LiyiqiInOsakaUniversity/control_board_set/firmware/README

The raspberry pi is the only supported platform yet.
The teensy code will be deleted in the future.
