LiyiqiInOsakaUniversity/control_board_set/electronics/dual/control_board.brd

## EAGLE design electronics/dual/control_board.brd (2020-11-19)

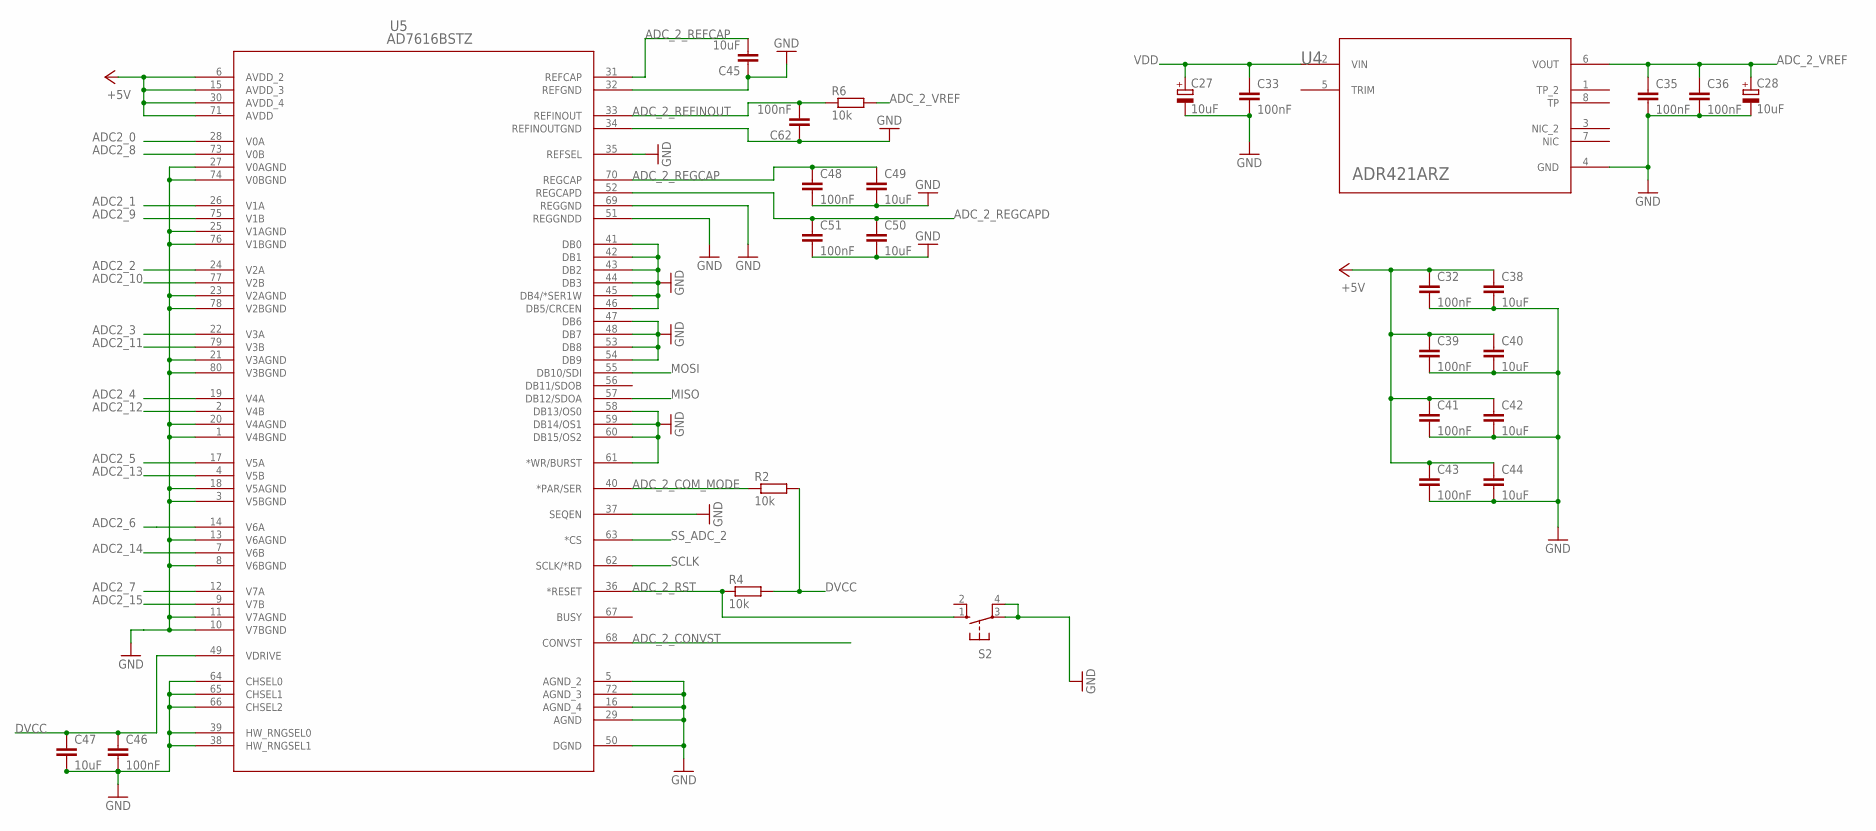
[picture p1: schematic control_board.sch, sheet 1, ADC]

Parts:
C27, C28: 10uF; SMC_A
C32, C33, C35, C36, C39, C41, C43, C46, C48, C51, C62: 100nF; C0603
C38, C40, C42, C44, C45, C47, C49, C50: 10uF; C0603
R2, R4, R6: 10k; R0603
S2: 10-XX; B3F-10XX
U4: ADR421ARZ; R_8
U5: AD7616BSTZ; ST_80_2

Connections:
+5V: C32.1, C38.1, C39.1, C40.1, C41.1, C42.1, C43.1, C44.1, U5.6 (AVDD_2), U5.15 (AVDD_3), U5.30 (AVDD_4), U5.71 (AVDD); also elsewhere on the board
ADC2_0: U5.28 (V0A); also elsewhere on the board
ADC2_1: U5.26 (V1A); also elsewhere on the board
ADC2_2: U5.24 (V2A); also elsewhere on the board
ADC2_3: U5.22 (V3A); also elsewhere on the board
ADC2_4: U5.19 (V4A); also elsewhere on the board
ADC2_5: U5.17 (V5A); also elsewhere on the board
ADC2_6: U5.14 (V6A); also elsewhere on the board
ADC2_7: U5.12 (V7A); also elsewhere on the board
ADC2_8: U5.73 (V0B); also elsewhere on the board
ADC2_9: U5.75 (V1B); also elsewhere on the board
ADC2_10: U5.77 (V2B); also elsewhere on the board
ADC2_11: U5.79 (V3B); also elsewhere on the board
ADC2_12: U5.2 (V4B); also elsewhere on the board
ADC2_13: U5.4 (V5B); also elsewhere on the board
ADC2_14: U5.7 (V6B); also elsewhere on the board
ADC2_15: U5.9 (V7B); also elsewhere on the board
ADC_2_COM_MODE: R2.1, U5.40 (*PAR/SER)
ADC_2_CONVST: U5.68 (CONVST); also elsewhere on the board
ADC_2_REFCAP: C45.2, U5.31 (REFCAP)
ADC_2_REFINOUT: C62.2, R6.1, U5.33 (REFINOUT)
ADC_2_REGCAP: C48.1, C49.1, U5.70 (REGCAP)
ADC_2_REGCAPD: C50.1, C51.1, U5.52 (REGCAPD)
ADC_2_RST: R4.1, S2.1 (S), U5.36 (*RESET)
ADC_2_VREF: C28.+, C35.1, C36.1, R6.2, U4.6 (VOUT)
DVCC: C46.1, C47.1, R2.2, R4.2, U5.49 (VDRIVE); also elsewhere on the board
GND: C27.-, C28.-, C32.2, C33.2, C35.2, C36.2, C38.2, C39.2, C40.2, C41.2, C42.2, C43.2, C44.2, C45.1, C46.2, C47.2, C48.2, C49.2, C50.2, C51.2, C62.1, S2.3, S2.4 (P1), U4.4 (GND), U5.1 (V4BGND), U5.3 (V5BGND), U5.5 (AGND_2), U5.8 (V6BGND), U5.10 (V7BGND), U5.11 (V7AGND), U5.13 (V6AGND), U5.16 (AGND_4), U5.18 (V5AGND), U5.20 (V4AGND), U5.21 (V3AGND), U5.23 (V2AGND), U5.25 (V1AGND), U5.27 (V0AGND), U5.29 (AGND), U5.32 (REFGND), U5.34 (REFINOUTGND), U5.35 (REFSEL), U5.37 (SEQEN), U5.38 (HW_RNGSEL1), U5.39 (HW_RNGSEL0), U5.41 (DB0), U5.42 (DB1), U5.43 (DB2), U5.44 (DB3), U5.45 (DB4/*SER1W), U5.46 (DB5/CRCEN), U5.47 (DB6), U5.48 (DB7), U5.50 (DGND), U5.51 (REGGNDD), U5.53 (DB8), U5.54 (DB9), U5.58 (DB13/OS0), U5.59 (DB14/OS1), U5.60 (DB15/OS2), U5.61 (*WR/BURST), U5.64 (CHSEL0), U5.65 (CHSEL1), U5.66 (CHSEL2), U5.69 (REGGND), U5.72 (AGND_3), U5.74 (V0BGND), U5.76 (V1BGND), U5.78 (V2BGND), U5.80 (V3BGND); also elsewhere on the board
MISO: U5.57 (DB12/SDOA); also elsewhere on the board
MOSI: U5.55 (DB10/SDI); also elsewhere on the board
SCLK: U5.62 (SCLK/*RD); also elsewhere on the board
SS_ADC_2: U5.63 (*CS); also elsewhere on the board
VDD: C27.+, C33.1, U4.2 (VIN); also elsewhere on the board

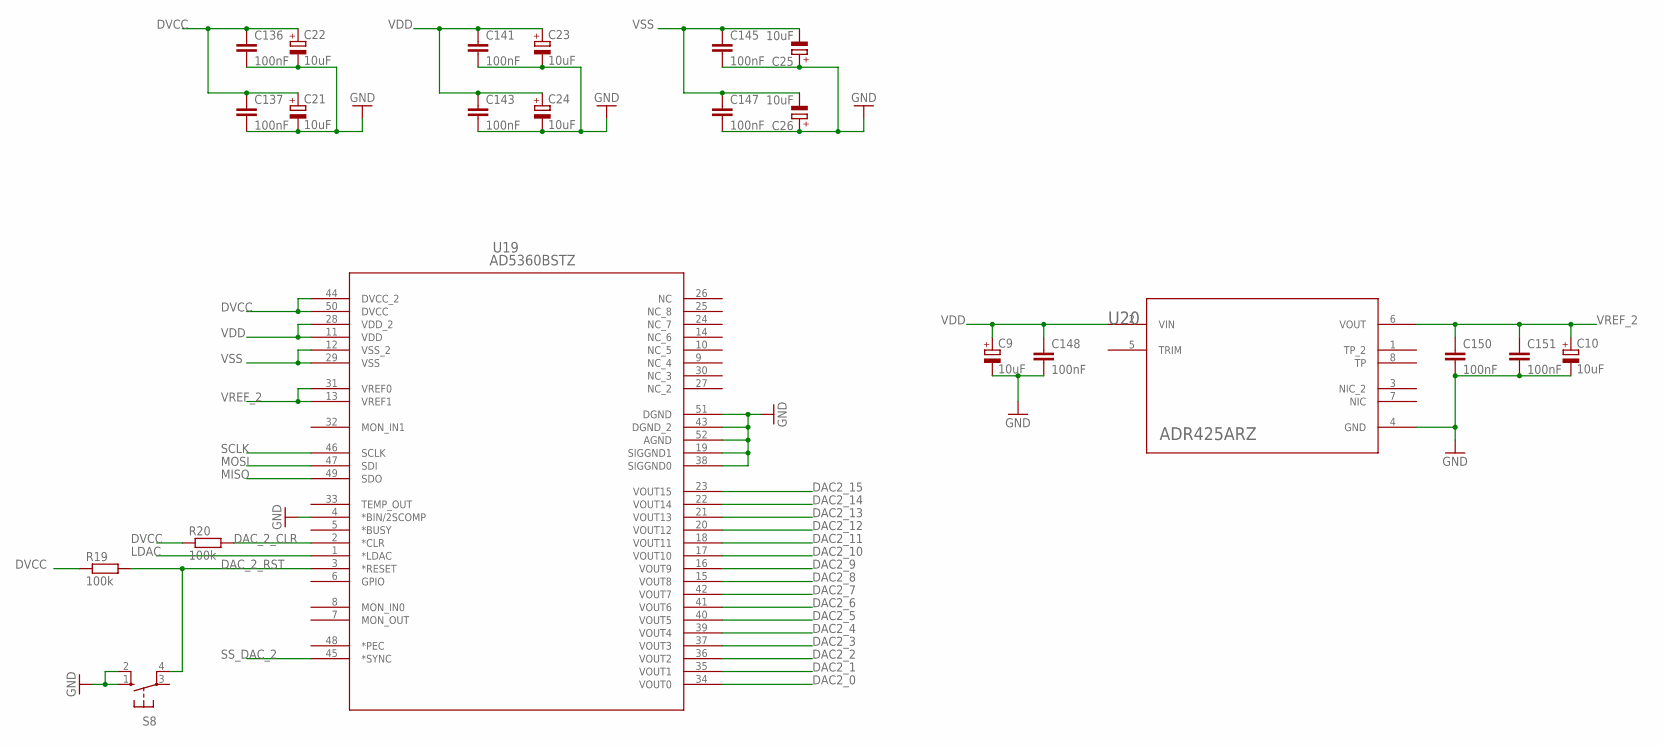
[picture p2: schematic control_board.sch, sheet 2, DAC]

Parts:
C9, C10, C21, C22, C23, C24, C25, C26: 10uF; SMC_A
C136, C137, C141, C143, C145, C147, C148, C150, C151: 100nF; C0603
R19, R20: 100k; R0603
S8: 10-XX; B3F-10XX
U19: AD5360BSTZ; ST_52
U20: ADR425ARZ; R_8

Connections:
DAC2_0: U19.34 (VOUT0); also elsewhere on the board
DAC2_1: U19.35 (VOUT1); also elsewhere on the board
DAC2_2: U19.36 (VOUT2); also elsewhere on the board
DAC2_3: U19.37 (VOUT3); also elsewhere on the board
DAC2_4: U19.39 (VOUT4); also elsewhere on the board
DAC2_5: U19.40 (VOUT5); also elsewhere on the board
DAC2_6: U19.41 (VOUT6); also elsewhere on the board
DAC2_7: U19.42 (VOUT7); also elsewhere on the board
DAC2_8: U19.15 (VOUT8); also elsewhere on the board
DAC2_9: U19.16 (VOUT9); also elsewhere on the board
DAC2_10: U19.17 (VOUT10); also elsewhere on the board
DAC2_11: U19.18 (VOUT11); also elsewhere on the board
DAC2_12: U19.20 (VOUT12); also elsewhere on the board
DAC2_13: U19.21 (VOUT13); also elsewhere on the board
DAC2_14: U19.22 (VOUT14); also elsewhere on the board
DAC2_15: U19.23 (VOUT15); also elsewhere on the board
DAC_2_CLR: R20.2, U19.2 (*CLR)
DAC_2_RST: R19.2, S8.4 (P1), U19.3 (*RESET)
DVCC: C21.+, C22.+, C136.1, C137.1, R19.1, R20.1, U19.44 (DVCC_2), U19.50 (DVCC); also elsewhere on the board
GND: C9.-, C10.-, C21.-, C22.-, C23.-, C24.-, C25.+, C26.+, C136.2, C137.2, C141.2, C143.2, C145.2, C147.2, C148.2, C150.2, C151.2, S8.1 (S), S8.2 (S1), U19.4 (*BIN/2SCOMP), U19.19 (SIGGND1), U19.38 (SIGGND0), U19.43 (DGND_2), U19.51 (DGND), U19.52 (AGND), U20.4 (GND); also elsewhere on the board
LDAC: U19.1 (*LDAC); also elsewhere on the board
MISO: U19.49 (SDO); also elsewhere on the board
MOSI: U19.47 (SDI); also elsewhere on the board
SCLK: U19.46 (SCLK); also elsewhere on the board
SS_DAC_2: U19.45 (*SYNC); also elsewhere on the board
VDD: C9.+, C23.+, C24.+, C141.1, C143.1, C148.1, U19.11 (VDD), U19.28 (VDD_2), U20.2 (VIN); also elsewhere on the board
VREF_2: C10.+, C150.1, C151.1, U19.13 (VREF1), U19.31 (VREF0), U20.6 (VOUT)
VSS: C25.-, C26.-, C145.1, C147.1, U19.12 (VSS_2), U19.29 (VSS); also elsewhere on the board

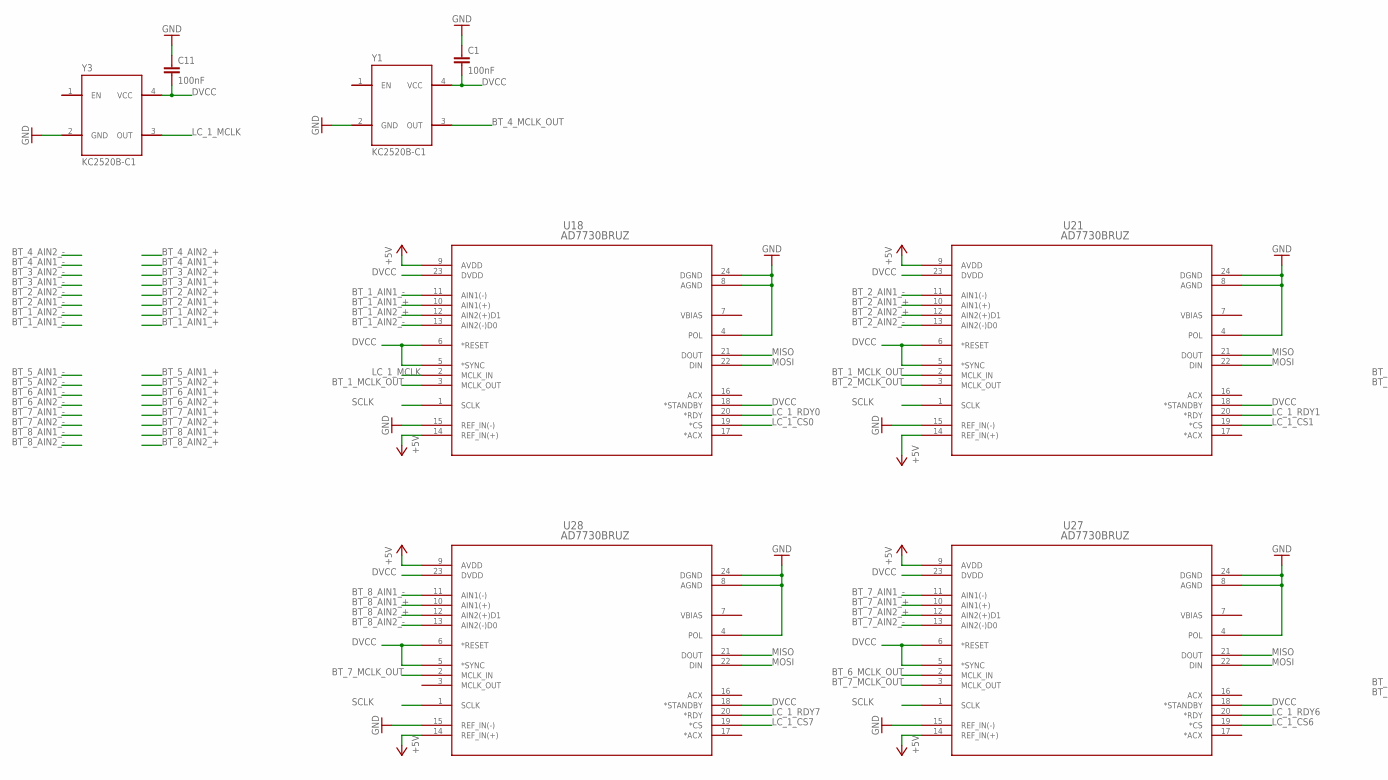
[picture p3: schematic control_board.sch, sheet 3, LoadCell, part in row 1, column 1]

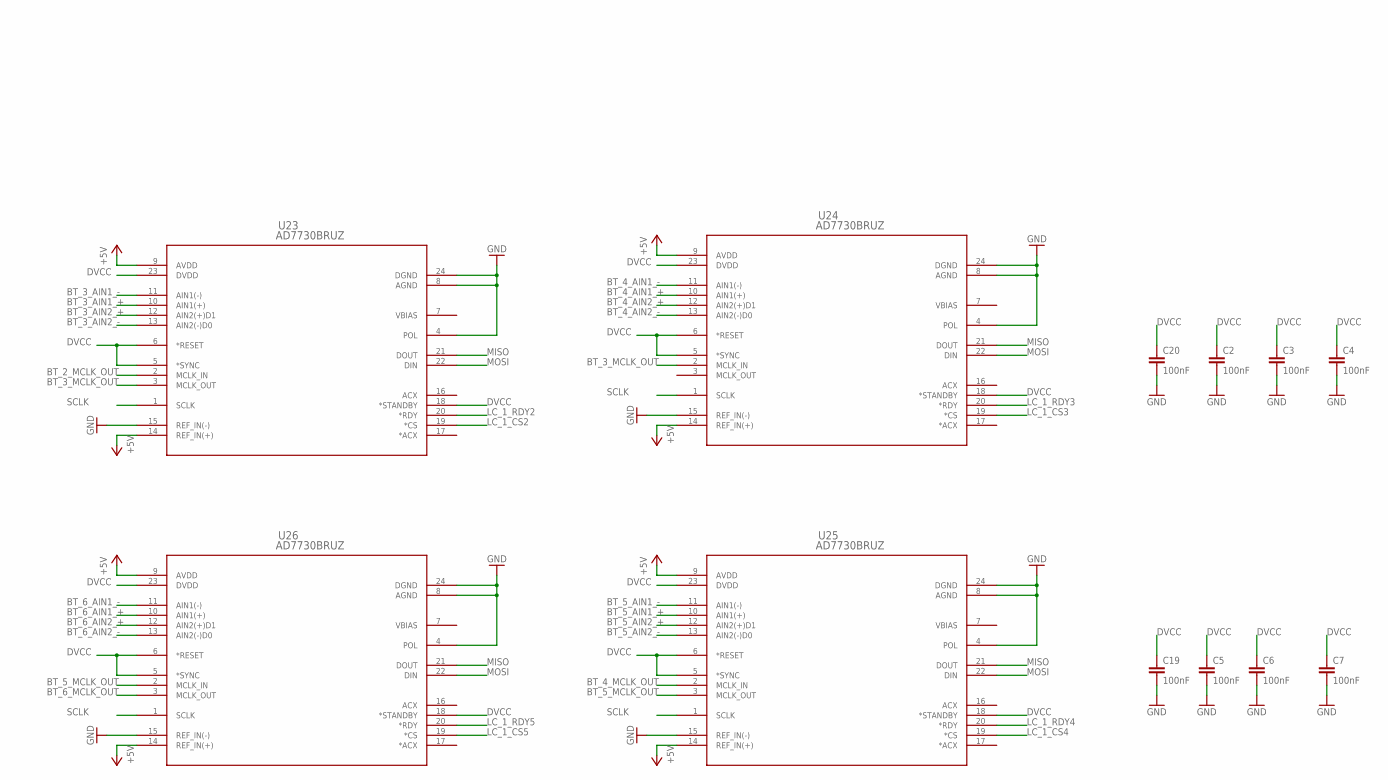
[picture p4: schematic control_board.sch, sheet 3, LoadCell, part in row 1, column 2]

Parts:
C1, C2, C3, C4, C5, C6, C7, C11, C19, C20: 100nF; C0603
U18, U21, U23, U24, U25, U26, U27, U28: AD7730BRUZ; RU_24
Y1, Y3: KC2520B-C1

Connections:
+5V: U18.9 (AVDD), U18.14 (REF_IN(+)), U21.9 (AVDD), U21.14 (REF_IN(+)), U23.9 (AVDD), U23.14 (REF_IN(+)), U24.9 (AVDD), U24.14 (REF_IN(+)), U25.9 (AVDD), U25.14 (REF_IN(+)), U26.9 (AVDD), U26.14 (REF_IN(+)), U27.9 (AVDD), U27.14 (REF_IN(+)), U28.9 (AVDD), U28.14 (REF_IN(+)); also elsewhere on the board
BT_1_AIN1_+: U18.10 (AIN1(+)); also elsewhere on the board
BT_1_AIN1_-: U18.11 (AIN1(-)); also elsewhere on the board
BT_1_AIN2_+: U18.12 (AIN2(+)D1); also elsewhere on the board
BT_1_AIN2_-: U18.13 (AIN2(-)D0); also elsewhere on the board
BT_1_MCLK_OUT: U18.3 (MCLK_OUT), U21.2 (MCLK_IN)
BT_2_AIN1_+: U21.10 (AIN1(+)); also elsewhere on the board
BT_2_AIN1_-: U21.11 (AIN1(-)); also elsewhere on the board
BT_2_AIN2_+: U21.12 (AIN2(+)D1); also elsewhere on the board
BT_2_AIN2_-: U21.13 (AIN2(-)D0); also elsewhere on the board
BT_2_MCLK_OUT: U21.3 (MCLK_OUT), U23.2 (MCLK_IN)
BT_3_AIN1_+: U23.10 (AIN1(+)); also elsewhere on the board
BT_3_AIN1_-: U23.11 (AIN1(-)); also elsewhere on the board
BT_3_AIN2_+: U23.12 (AIN2(+)D1); also elsewhere on the board
BT_3_AIN2_-: U23.13 (AIN2(-)D0); also elsewhere on the board
BT_3_MCLK_OUT: U23.3 (MCLK_OUT), U24.2 (MCLK_IN)
BT_4_AIN1_+: U24.10 (AIN1(+)); also elsewhere on the board
BT_4_AIN1_-: U24.11 (AIN1(-)); also elsewhere on the board
BT_4_AIN2_+: U24.12 (AIN2(+)D1); also elsewhere on the board
BT_4_AIN2_-: U24.13 (AIN2(-)D0); also elsewhere on the board
BT_4_MCLK_OUT: U25.2 (MCLK_IN), Y1.3 (OUT)
BT_5_AIN1_+: U25.10 (AIN1(+)); also elsewhere on the board
BT_5_AIN1_-: U25.11 (AIN1(-)); also elsewhere on the board
BT_5_AIN2_+: U25.12 (AIN2(+)D1); also elsewhere on the board
BT_5_AIN2_-: U25.13 (AIN2(-)D0); also elsewhere on the board
BT_5_MCLK_OUT: U25.3 (MCLK_OUT), U26.2 (MCLK_IN)
BT_6_AIN1_+: U26.10 (AIN1(+)); also elsewhere on the board
BT_6_AIN1_-: U26.11 (AIN1(-)); also elsewhere on the board
BT_6_AIN2_+: U26.12 (AIN2(+)D1); also elsewhere on the board
BT_6_AIN2_-: U26.13 (AIN2(-)D0); also elsewhere on the board
BT_6_MCLK_OUT: U26.3 (MCLK_OUT), U27.2 (MCLK_IN)
BT_7_AIN1_+: U27.10 (AIN1(+)); also elsewhere on the board
BT_7_AIN1_-: U27.11 (AIN1(-)); also elsewhere on the board
BT_7_AIN2_+: U27.12 (AIN2(+)D1); also elsewhere on the board
BT_7_AIN2_-: U27.13 (AIN2(-)D0); also elsewhere on the board
BT_7_MCLK_OUT: U27.3 (MCLK_OUT), U28.2 (MCLK_IN)
BT_8_AIN1_+: U28.10 (AIN1(+)); also elsewhere on the board
BT_8_AIN1_-: U28.11 (AIN1(-)); also elsewhere on the board
BT_8_AIN2_+: U28.12 (AIN2(+)D1); also elsewhere on the board
BT_8_AIN2_-: U28.13 (AIN2(-)D0); also elsewhere on the board
DVCC: C1.2, C2.1, C3.1, C4.1, C5.1, C6.1, C7.1, C11.2, C19.1, C20.1, U18.5 (*SYNC), U18.6 (*RESET), U18.18 (*STANDBY), U18.23 (DVDD), U21.5 (*SYNC), U21.6 (*RESET), U21.18 (*STANDBY), U21.23 (DVDD), U23.5 (*SYNC), U23.6 (*RESET), U23.18 (*STANDBY), U23.23 (DVDD), U24.5 (*SYNC), U24.6 (*RESET), U24.18 (*STANDBY), U24.23 (DVDD), U25.5 (*SYNC), U25.6 (*RESET), U25.18 (*STANDBY), U25.23 (DVDD), U26.5 (*SYNC), U26.6 (*RESET), U26.18 (*STANDBY), U26.23 (DVDD), U27.5 (*SYNC), U27.6 (*RESET), U27.18 (*STANDBY), U27.23 (DVDD), U28.5 (*SYNC), U28.6 (*RESET), U28.18 (*STANDBY), U28.23 (DVDD), Y1.4 (VCC), Y3.4 (VCC); also elsewhere on the board
GND: C1.1, C2.2, C3.2, C4.2, C5.2, C6.2, C7.2, C11.1, C19.2, C20.2, U18.4 (POL), U18.8 (AGND), U18.15 (REF_IN(-)), U18.24 (DGND), U21.4 (POL), U21.8 (AGND), U21.15 (REF_IN(-)), U21.24 (DGND), U23.4 (POL), U23.8 (AGND), U23.15 (REF_IN(-)), U23.24 (DGND), U24.4 (POL), U24.8 (AGND), U24.15 (REF_IN(-)), U24.24 (DGND), U25.4 (POL), U25.8 (AGND), U25.15 (REF_IN(-)), U25.24 (DGND), U26.4 (POL), U26.8 (AGND), U26.15 (REF_IN(-)), U26.24 (DGND), U27.4 (POL), U27.8 (AGND), U27.15 (REF_IN(-)), U27.24 (DGND), U28.4 (POL), U28.8 (AGND), U28.15 (REF_IN(-)), U28.24 (DGND), Y1.2 (GND), Y3.2 (GND); also elsewhere on the board
LC_1_CS0: U18.19 (*CS); also elsewhere on the board
LC_1_CS1: U21.19 (*CS); also elsewhere on the board
LC_1_CS2: U23.19 (*CS); also elsewhere on the board
LC_1_CS3: U24.19 (*CS); also elsewhere on the board
LC_1_CS4: U25.19 (*CS); also elsewhere on the board
LC_1_CS5: U26.19 (*CS); also elsewhere on the board
LC_1_CS6: U27.19 (*CS); also elsewhere on the board
LC_1_CS7: U28.19 (*CS); also elsewhere on the board
LC_1_MCLK: U18.2 (MCLK_IN), Y3.3 (OUT)
LC_1_RDY0: U18.20 (*RDY); also elsewhere on the board
LC_1_RDY1: U21.20 (*RDY); also elsewhere on the board
LC_1_RDY2: U23.20 (*RDY); also elsewhere on the board
LC_1_RDY3: U24.20 (*RDY); also elsewhere on the board
LC_1_RDY4: U25.20 (*RDY); also elsewhere on the board
LC_1_RDY5: U26.20 (*RDY); also elsewhere on the board
LC_1_RDY6: U27.20 (*RDY); also elsewhere on the board
LC_1_RDY7: U28.20 (*RDY); also elsewhere on the board
MISO: U18.21 (DOUT), U21.21 (DOUT), U23.21 (DOUT), U24.21 (DOUT), U25.21 (DOUT), U26.21 (DOUT), U27.21 (DOUT), U28.21 (DOUT); also elsewhere on the board
MOSI: U18.22 (DIN), U21.22 (DIN), U23.22 (DIN), U24.22 (DIN), U25.22 (DIN), U26.22 (DIN), U27.22 (DIN), U28.22 (DIN); also elsewhere on the board
SCLK: U18.1 (SCLK), U21.1 (SCLK), U23.1 (SCLK), U24.1 (SCLK), U25.1 (SCLK), U26.1 (SCLK), U27.1 (SCLK), U28.1 (SCLK); also elsewhere on the board

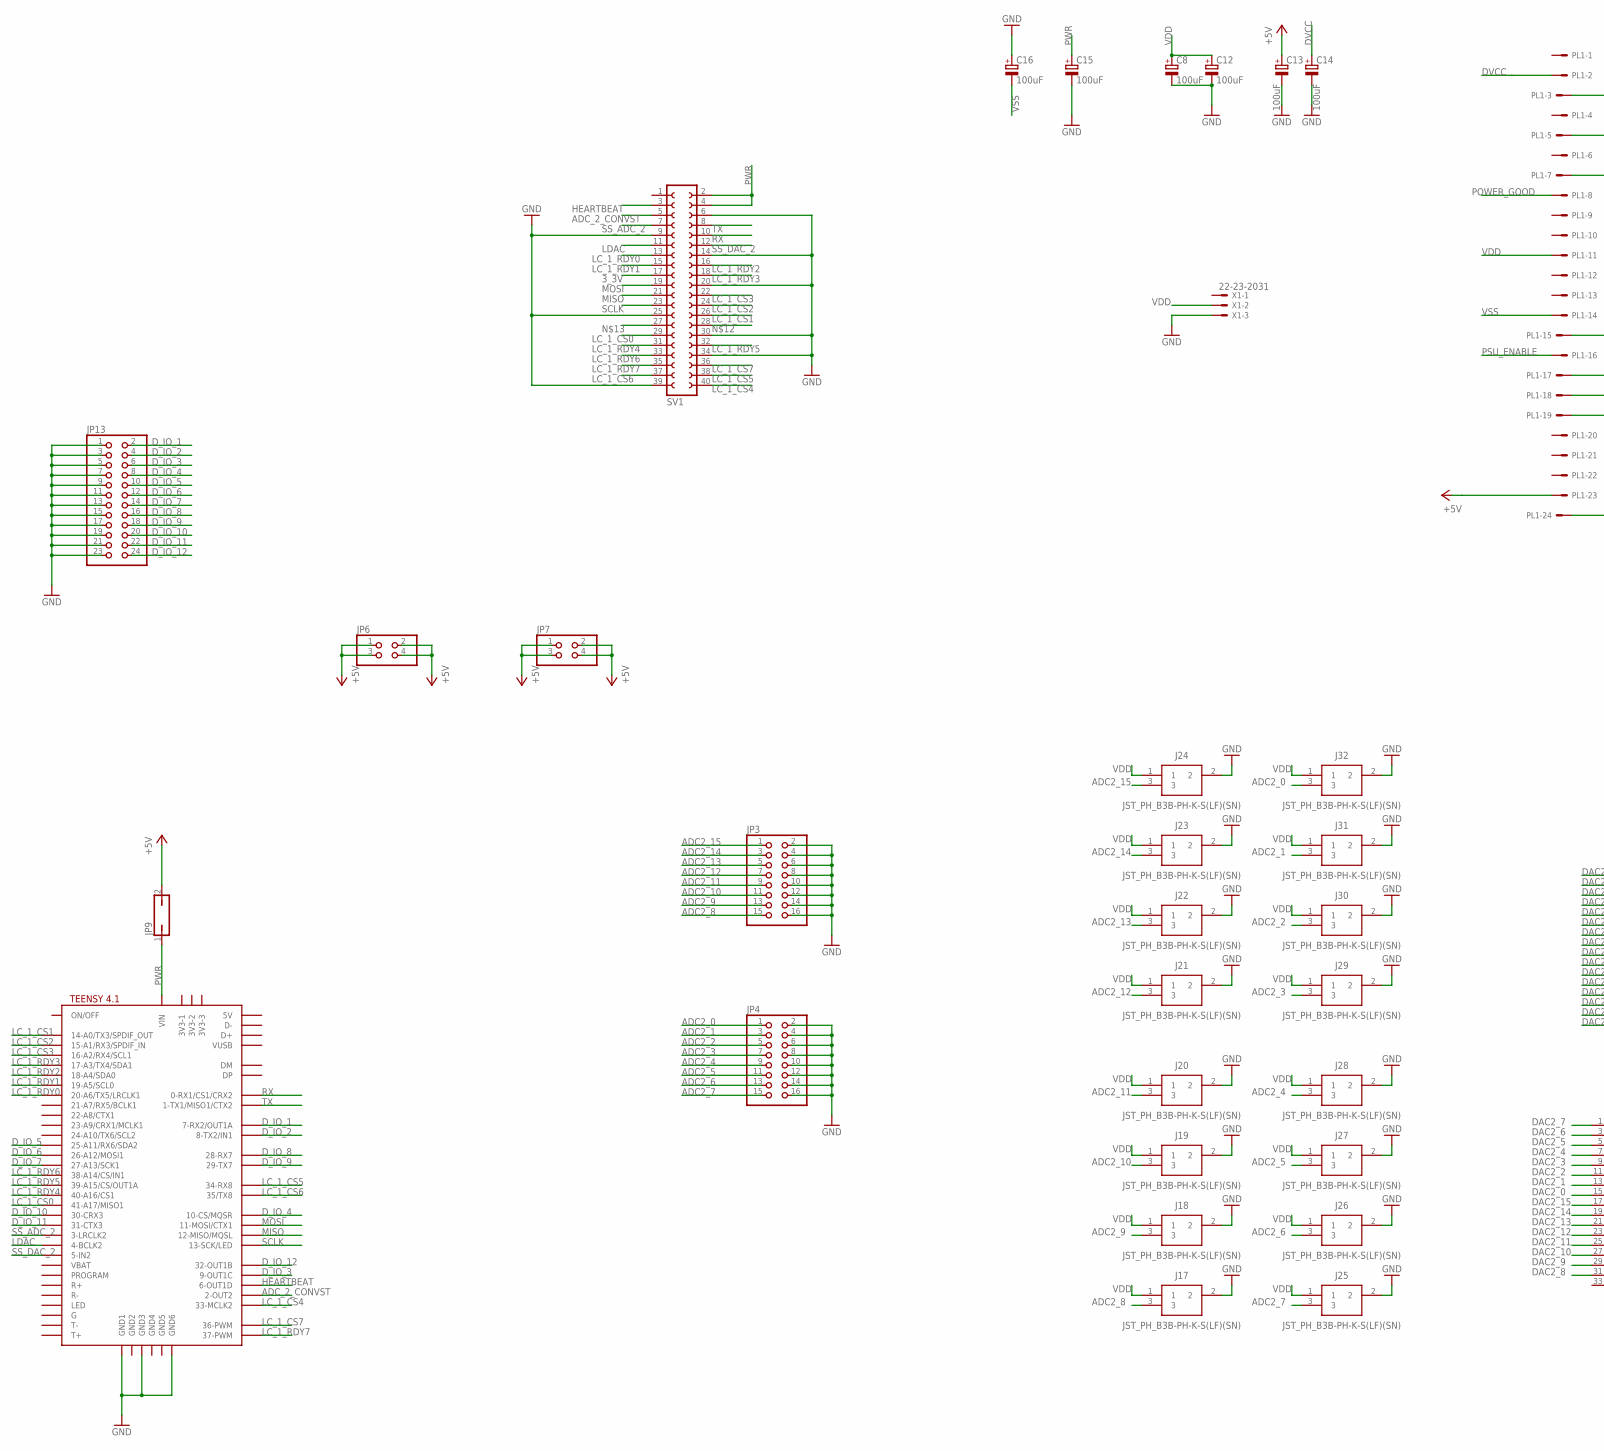
[picture p5: schematic control_board.sch, sheet 4, Connectors, part in row 1, column 1]

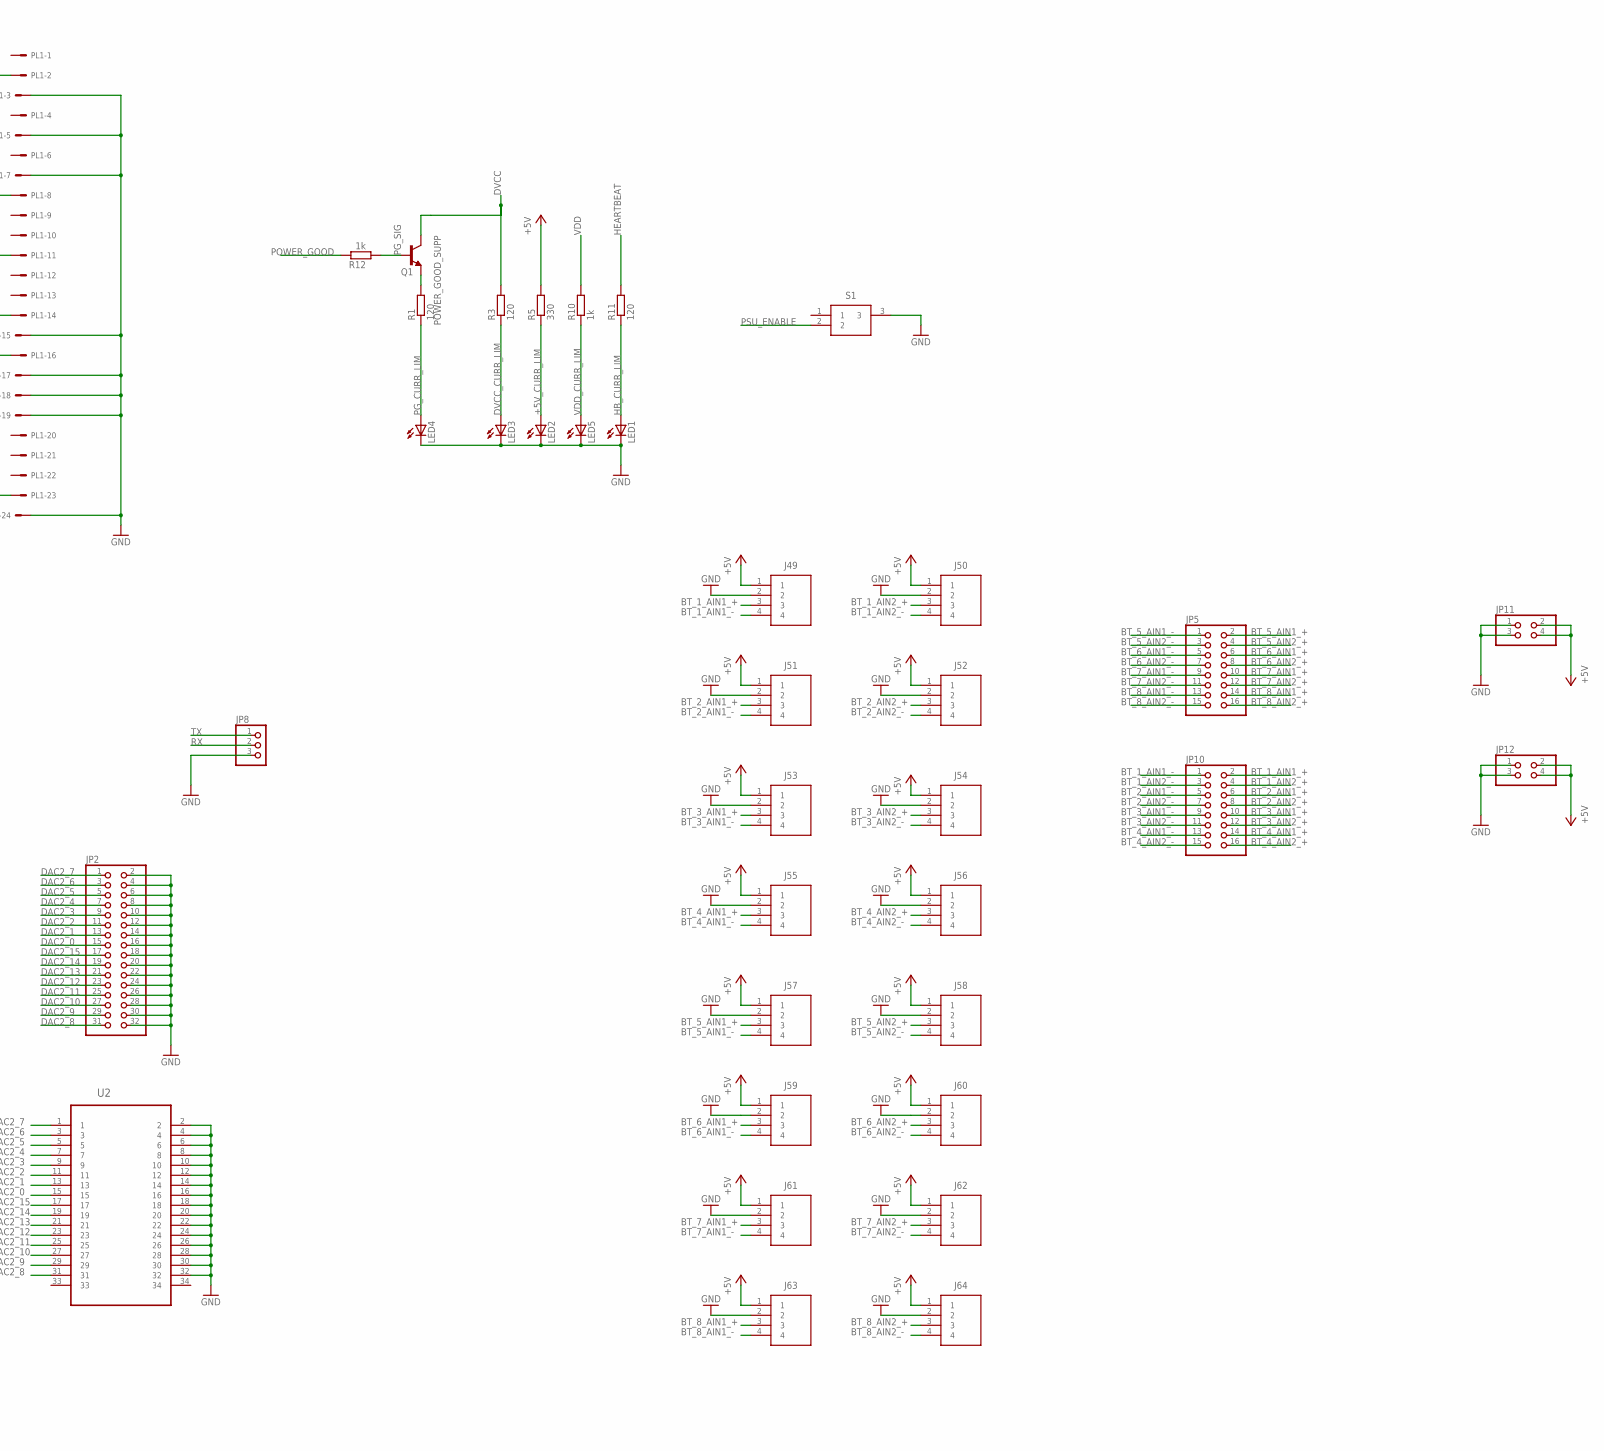
[picture p6: schematic control_board.sch, sheet 4, Connectors, part in row 1, column 2]

Parts:
C8, C12, C13, C14, C15, C16: 100uF; E3,5-8
J17, J18, J19, J20, J21, J22, J23, J24, J25, J26, J27, J28, J29, J30, J31, J32: JST_PH_B3B-PH-K-S(LF)(SN); JST_PH_SHDR3W50P0X200_1X3_790X450X600
J49, J50, J51, J52, J53, J54, J55, J56, J57, J58, J59, J60, J61, J62, J63, J64: B4B-PH-K-S(LF)(SN); SHDR4W50P0X200_1X4_990X450X600
JP2: PINHD-2X16/90; 2X16/90
JP3, JP4: PINHD-2X8/90; 2X08/90
JP5, JP10: PINHD-2X8; 2X08
JP6, JP7: PINHD-2X2/90; 2X02/90
JP8: PINHD-1X3; 1X03
JP9: JP1Q; JP1
JP11, JP12: PINHD-2X2; 2X02
JP13: PINHD-2X12_2.54-SMD; 2X12SMD
LED1, LED2, LED3, LED4, LED5: LEDCHIP-LED0603; CHIP-LED0603
PL1: 555X-24V; 5566-24
Q1: BCF29SMD; SOT23-BEC
R1, R3, R11: 120; R0805
R5: 330; R0805
R10, R12: 1k; R0805
S1: 1MS1T1B1M2QES-5
SV1: FE20-2
U2: AMP-5103309-7-34PIN_5103309-7; AMP-5103309-7-34PIN_TYCO_5103309-7
U$1: TEENSY41
X1: 22-23-2031

Connections:
3_3V: SV1.17
+5V: C13.+, J49.1, J50.1, J51.1, J52.1, J53.1, J54.1, J55.1, J56.1, J57.1, J58.1, J59.1, J60.1, J61.1, J62.1, J63.1, J64.1, JP6.1, JP6.2, JP6.3, JP6.4, JP7.1, JP7.2, JP7.3, JP7.4, JP9.2, JP11.2, JP11.4, JP12.2, JP12.4, PL1.23, R5.2; also elsewhere on the board
+5V_CURR_LIM: LED2.A, R5.1
ADC2_0: J32.3, JP4.1; also elsewhere on the board
ADC2_1: J31.3, JP4.3; also elsewhere on the board
ADC2_2: J30.3, JP4.5; also elsewhere on the board
ADC2_3: J29.3, JP4.7; also elsewhere on the board
ADC2_4: J28.3, JP4.9; also elsewhere on the board
ADC2_5: J27.3, JP4.11; also elsewhere on the board
ADC2_6: J26.3, JP4.13; also elsewhere on the board
ADC2_7: J25.3, JP4.15; also elsewhere on the board
ADC2_8: J17.3, JP3.15; also elsewhere on the board
ADC2_9: J18.3, JP3.13; also elsewhere on the board
ADC2_10: J19.3, JP3.11; also elsewhere on the board
ADC2_11: J20.3, JP3.9; also elsewhere on the board
ADC2_12: J21.3, JP3.7; also elsewhere on the board
ADC2_13: J22.3, JP3.5; also elsewhere on the board
ADC2_14: J23.3, JP3.3; also elsewhere on the board
ADC2_15: J24.3, JP3.1; also elsewhere on the board
ADC_2_CONVST: SV1.5, U$1.2-OUT2; also elsewhere on the board
BT_1_AIN1_+: J49.3, JP10.2; also elsewhere on the board
BT_1_AIN1_-: J49.4, JP10.1; also elsewhere on the board
BT_1_AIN2_+: J50.3, JP10.4; also elsewhere on the board
BT_1_AIN2_-: J50.4, JP10.3; also elsewhere on the board
BT_2_AIN1_+: J51.3, JP10.6; also elsewhere on the board
BT_2_AIN1_-: J51.4, JP10.5; also elsewhere on the board
BT_2_AIN2_+: J52.3, JP10.8; also elsewhere on the board
BT_2_AIN2_-: J52.4, JP10.7; also elsewhere on the board
BT_3_AIN1_+: J53.3, JP10.10; also elsewhere on the board
BT_3_AIN1_-: J53.4, JP10.9; also elsewhere on the board
BT_3_AIN2_+: J54.3, JP10.12; also elsewhere on the board
BT_3_AIN2_-: J54.4, JP10.11; also elsewhere on the board
BT_4_AIN1_+: J55.3, JP10.14; also elsewhere on the board
BT_4_AIN1_-: J55.4, JP10.13; also elsewhere on the board
BT_4_AIN2_+: J56.3, JP10.16; also elsewhere on the board
BT_4_AIN2_-: J56.4, JP10.15; also elsewhere on the board
BT_5_AIN1_+: J57.3, JP5.2; also elsewhere on the board
BT_5_AIN1_-: J57.4, JP5.1; also elsewhere on the board
BT_5_AIN2_+: J58.3, JP5.4; also elsewhere on the board
BT_5_AIN2_-: J58.4, JP5.3; also elsewhere on the board
BT_6_AIN1_+: J59.3, JP5.6; also elsewhere on the board
BT_6_AIN1_-: J59.4, JP5.5; also elsewhere on the board
BT_6_AIN2_+: J60.3, JP5.8; also elsewhere on the board
BT_6_AIN2_-: J60.4, JP5.7; also elsewhere on the board
BT_7_AIN1_+: J61.3, JP5.10; also elsewhere on the board
BT_7_AIN1_-: J61.4, JP5.9; also elsewhere on the board
BT_7_AIN2_+: J62.3, JP5.12; also elsewhere on the board
BT_7_AIN2_-: J62.4, JP5.11; also elsewhere on the board
BT_8_AIN1_+: J63.3, JP5.14; also elsewhere on the board
BT_8_AIN1_-: J63.4, JP5.13; also elsewhere on the board
BT_8_AIN2_+: J64.3, JP5.16; also elsewhere on the board
BT_8_AIN2_-: J64.4, JP5.15; also elsewhere on the board
DAC2_0: JP2.15, U2.15; also elsewhere on the board
DAC2_1: JP2.13, U2.13; also elsewhere on the board
DAC2_2: JP2.11, U2.11; also elsewhere on the board
DAC2_3: JP2.9, U2.9; also elsewhere on the board
DAC2_4: JP2.7, U2.7; also elsewhere on the board
DAC2_5: JP2.5, U2.5; also elsewhere on the board
DAC2_6: JP2.3, U2.3; also elsewhere on the board
DAC2_7: JP2.1, U2.1; also elsewhere on the board
DAC2_8: JP2.31, U2.31; also elsewhere on the board
DAC2_9: JP2.29, U2.29; also elsewhere on the board
DAC2_10: JP2.27, U2.27; also elsewhere on the board
DAC2_11: JP2.25, U2.25; also elsewhere on the board
DAC2_12: JP2.23, U2.23; also elsewhere on the board
DAC2_13: JP2.21, U2.21; also elsewhere on the board
DAC2_14: JP2.19, U2.19; also elsewhere on the board
DAC2_15: JP2.17, U2.17; also elsewhere on the board
DVCC: C14.+, PL1.2, Q1.C, R3.2; also elsewhere on the board
DVCC_CURR_LIM: LED3.A, R3.1
D_IO_1: JP13.2, U$1.7-RX2/OUT1A
D_IO_2: JP13.4, U$1.8-TX2/IN2 (8-TX2/IN1)
D_IO_3: JP13.6, U$1.9-OUT1C
D_IO_4: JP13.8, U$1.10-CS\MQSR (10-CS/MQSR)
D_IO_5: JP13.10, U$1.25-A11/RX6/SDA2
D_IO_6: JP13.12, U$1.26-A12/MOSI1
D_IO_7: JP13.14, U$1.27-A13/SCK1
D_IO_8: JP13.16, U$1.28-RX7
D_IO_9: JP13.18, U$1.29-TX7
D_IO_10: JP13.20, U$1.30-CRX3
D_IO_11: JP13.22, U$1.31-CTX3
D_IO_12: JP13.24, U$1.32-OUT1B
GND: C8.-, C12.-, C13.-, C14.-, C15.-, C16.+, J17.2, J18.2, J19.2, J20.2, J21.2, J22.2, J23.2, J24.2, J25.2, J26.2, J27.2, J28.2, J29.2, J30.2, J31.2, J32.2, J49.2, J50.2, J51.2, J52.2, J53.2, J54.2, J55.2, J56.2, J57.2, J58.2, J59.2, J60.2, J61.2, J62.2, J63.2, J64.2, JP2.2, JP2.4, JP2.6, JP2.8, JP2.10, JP2.12, JP2.14, JP2.16, JP2.18, JP2.20, JP2.22, JP2.24, JP2.26, JP2.28, JP2.30, JP2.32, JP3.2, JP3.4, JP3.6, JP3.8, JP3.10, JP3.12, JP3.14, JP3.16, JP4.2, JP4.4, JP4.6, JP4.8, JP4.10, JP4.12, JP4.14, JP4.16, JP8.3, JP11.1, JP11.3, JP12.1, JP12.3, JP13.1, JP13.3, JP13.5, JP13.7, JP13.9, JP13.11, JP13.13, JP13.15, JP13.17, JP13.19, JP13.21, JP13.23, LED1.C, LED2.C, LED3.C, LED4.C, LED5.C, PL1.3, PL1.5, PL1.7, PL1.15, PL1.17, PL1.18, PL1.19, PL1.24, S1.3, SV1.6, SV1.9, SV1.14, SV1.20, SV1.25, SV1.30, SV1.34, SV1.39, U2.2, U2.4, U2.6, U2.8, U2.10, U2.12, U2.14, U2.16, U2.18, U2.20, U2.22, U2.24, U2.26, U2.28, U2.30, U2.32, U$1.GND1, U$1.GND3, U$1.GND6, X1.3; also elsewhere on the board
HB_CURR_LIM: LED1.A, R11.1
HEARTBEAT: R11.2, SV1.3, U$1.6-OUT1D
LC_1_CS0: SV1.29, U$1.41-A17/MISO1; also elsewhere on the board
LC_1_CS1: SV1.26, U$1.14-A0/TX3/SPDIF_OUT; also elsewhere on the board
LC_1_CS2: SV1.24, U$1.15-A1/RX3/SPDIF_IN; also elsewhere on the board
LC_1_CS3: SV1.22, U$1.16-A2/RX4/SCL1; also elsewhere on the board
LC_1_CS4: SV1.40, U$1.33-MCLK2; also elsewhere on the board
LC_1_CS5: SV1.38, U$1.34-RX8; also elsewhere on the board
LC_1_CS6: SV1.37, U$1.35-TX8 (35/TX8); also elsewhere on the board
LC_1_CS7: SV1.36, U$1.36-PWM; also elsewhere on the board
LC_1_RDY0: SV1.13, U$1.20-A6/TX5/LRCLK1; also elsewhere on the board
LC_1_RDY1: SV1.15, U$1.19-A5/SCL0; also elsewhere on the board
LC_1_RDY2: SV1.16, U$1.18-A4/SDA0; also elsewhere on the board
LC_1_RDY3: SV1.18, U$1.17-A3/TX4/SDA1; also elsewhere on the board
LC_1_RDY4: SV1.31, U$1.40-A16/CS1; also elsewhere on the board
LC_1_RDY5: SV1.32, U$1.39-A15/CS/OUT1A; also elsewhere on the board
LC_1_RDY6: SV1.33, U$1.38-A14/CS/IN1; also elsewhere on the board
LC_1_RDY7: SV1.35, U$1.37-PWM; also elsewhere on the board
LDAC: SV1.11, U$1.4-BCLK2; also elsewhere on the board
MISO: SV1.21, U$1.12-MISO/MQSL; also elsewhere on the board
MOSI: SV1.19, U$1.11-MOSI/CTX1; also elsewhere on the board
PG_CURR_LIM: LED4.A, R1.1
PG_SIG: Q1.B, R12.1
POWER_GOOD: PL1.8, R12.2
POWER_GOOD_SUPP: Q1.E, R1.2
PSU_ENABLE: PL1.16, S1.2
PWR: C15.+, JP9.1, SV1.2, SV1.4, U$1.VIN
RX: JP8.2, SV1.10, U$1.0-RX1/CS1/CRX2
SCLK: SV1.23, U$1.13-SCK/LED; also elsewhere on the board
SS_ADC_2: SV1.7, U$1.3-LRCLK2; also elsewhere on the board
SS_DAC_2: SV1.12, U$1.5-IN2; also elsewhere on the board
TX: JP8.1, SV1.8, U$1.1-TX1/MISO1/CTX2
VDD: C8.+, C12.+, J17.1, J18.1, J19.1, J20.1, J21.1, J22.1, J23.1, J24.1, J25.1, J26.1, J27.1, J28.1, J29.1, J30.1, J31.1, J32.1, PL1.11, R10.2, X1.2; also elsewhere on the board
VDD_CURR_LIM: LED5.A, R10.1
VSS: C16.-, PL1.14; also elsewhere on the board
