LiyiqiInOsakaUniversity/control_board_set/electronics/dual/control_board.brd

## EAGLE design electronics/dual/control_board.brd (continued)

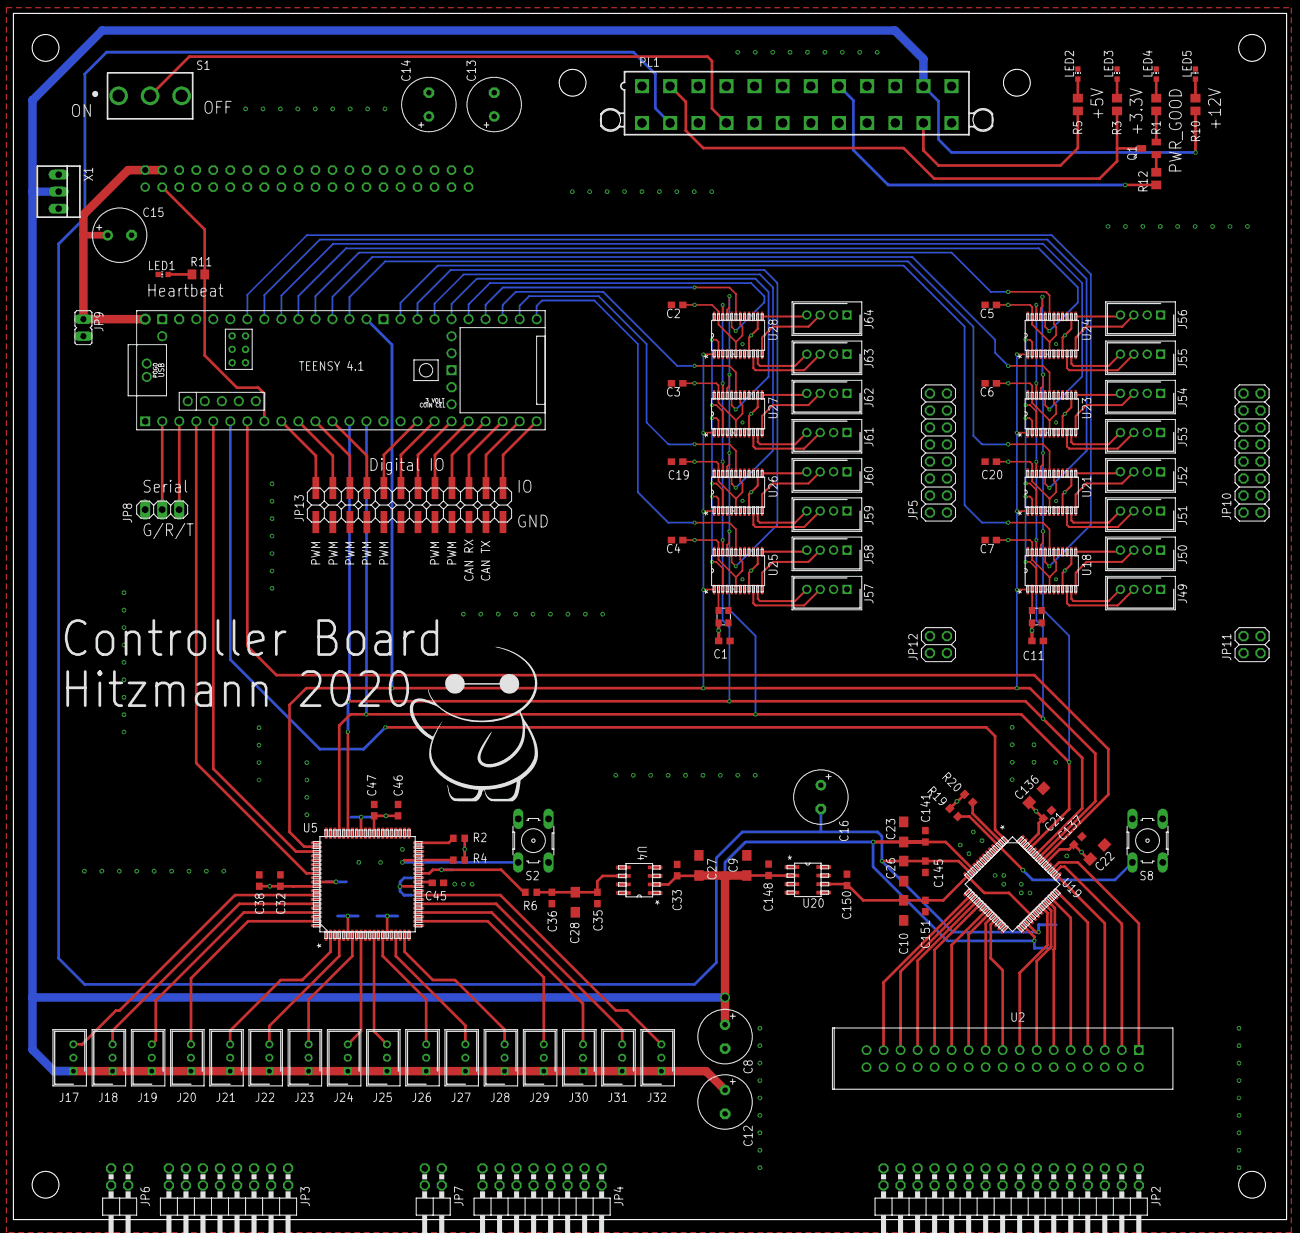
[picture p7: board control_board.brd from above]

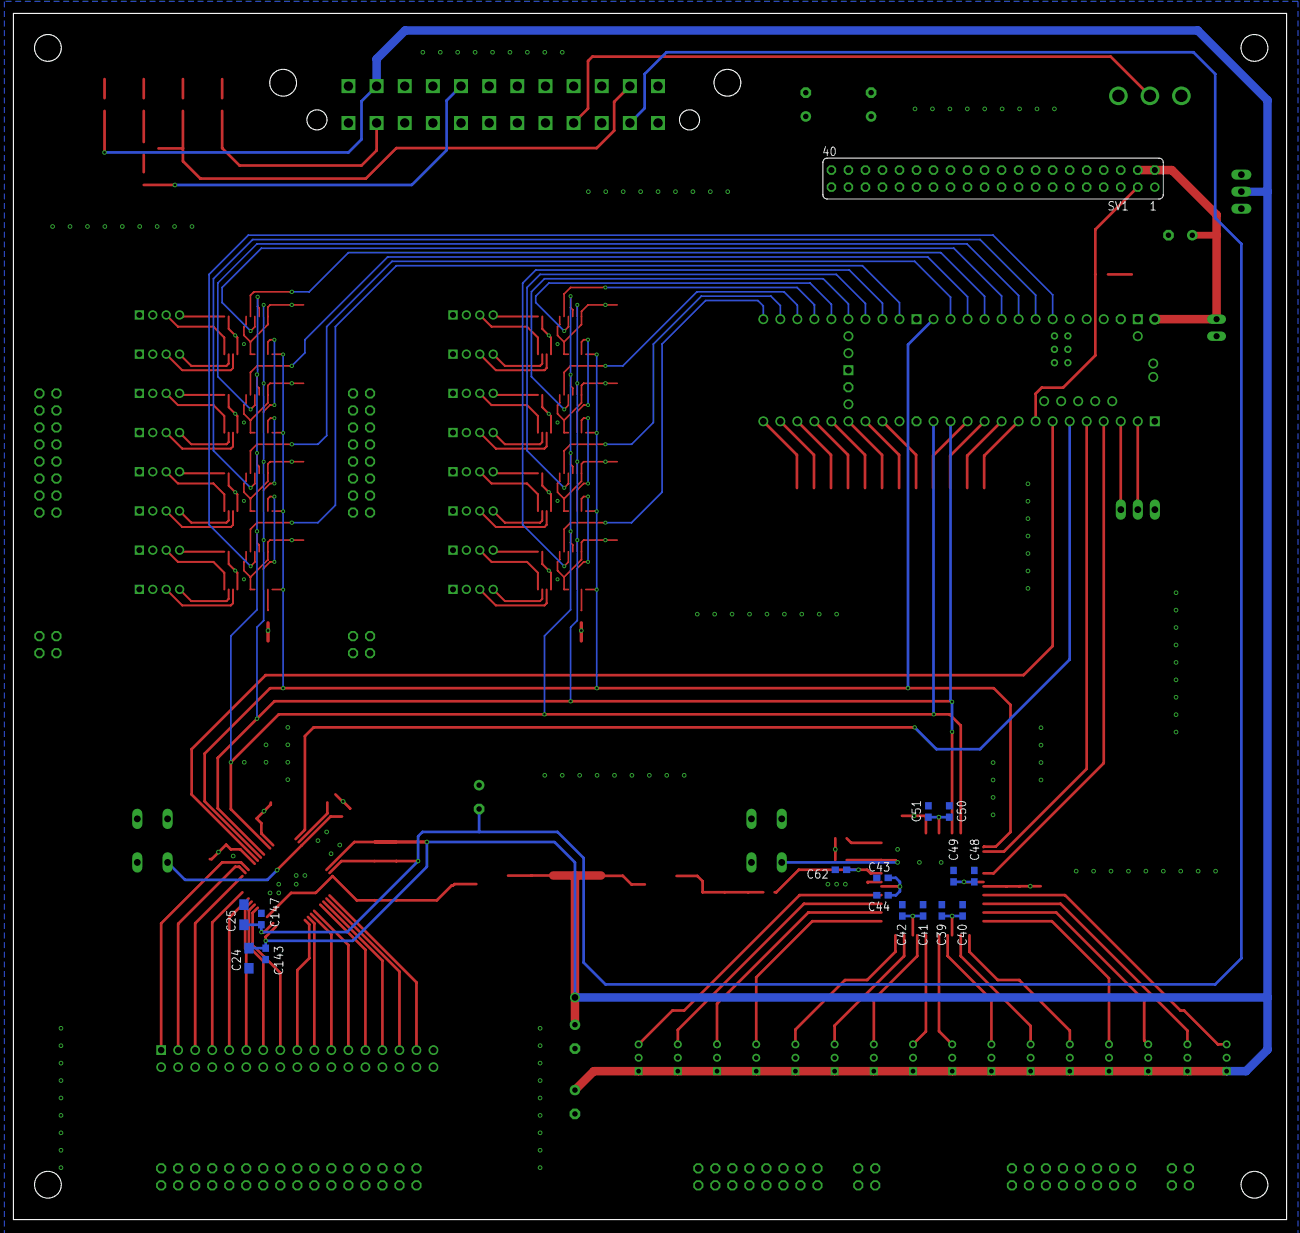
[picture p8: board control_board.brd from below]

Board: 4 copper layers, 190.0 x 180.0 mm, 137 parts (16 on the bottom side), 135 nets.
