LiyiqiInOsakaUniversity/control_board_set/electronics/tester_adapter_board.brd

## EAGLE design electronics/tester_adapter_board.brd (2020-11-19)

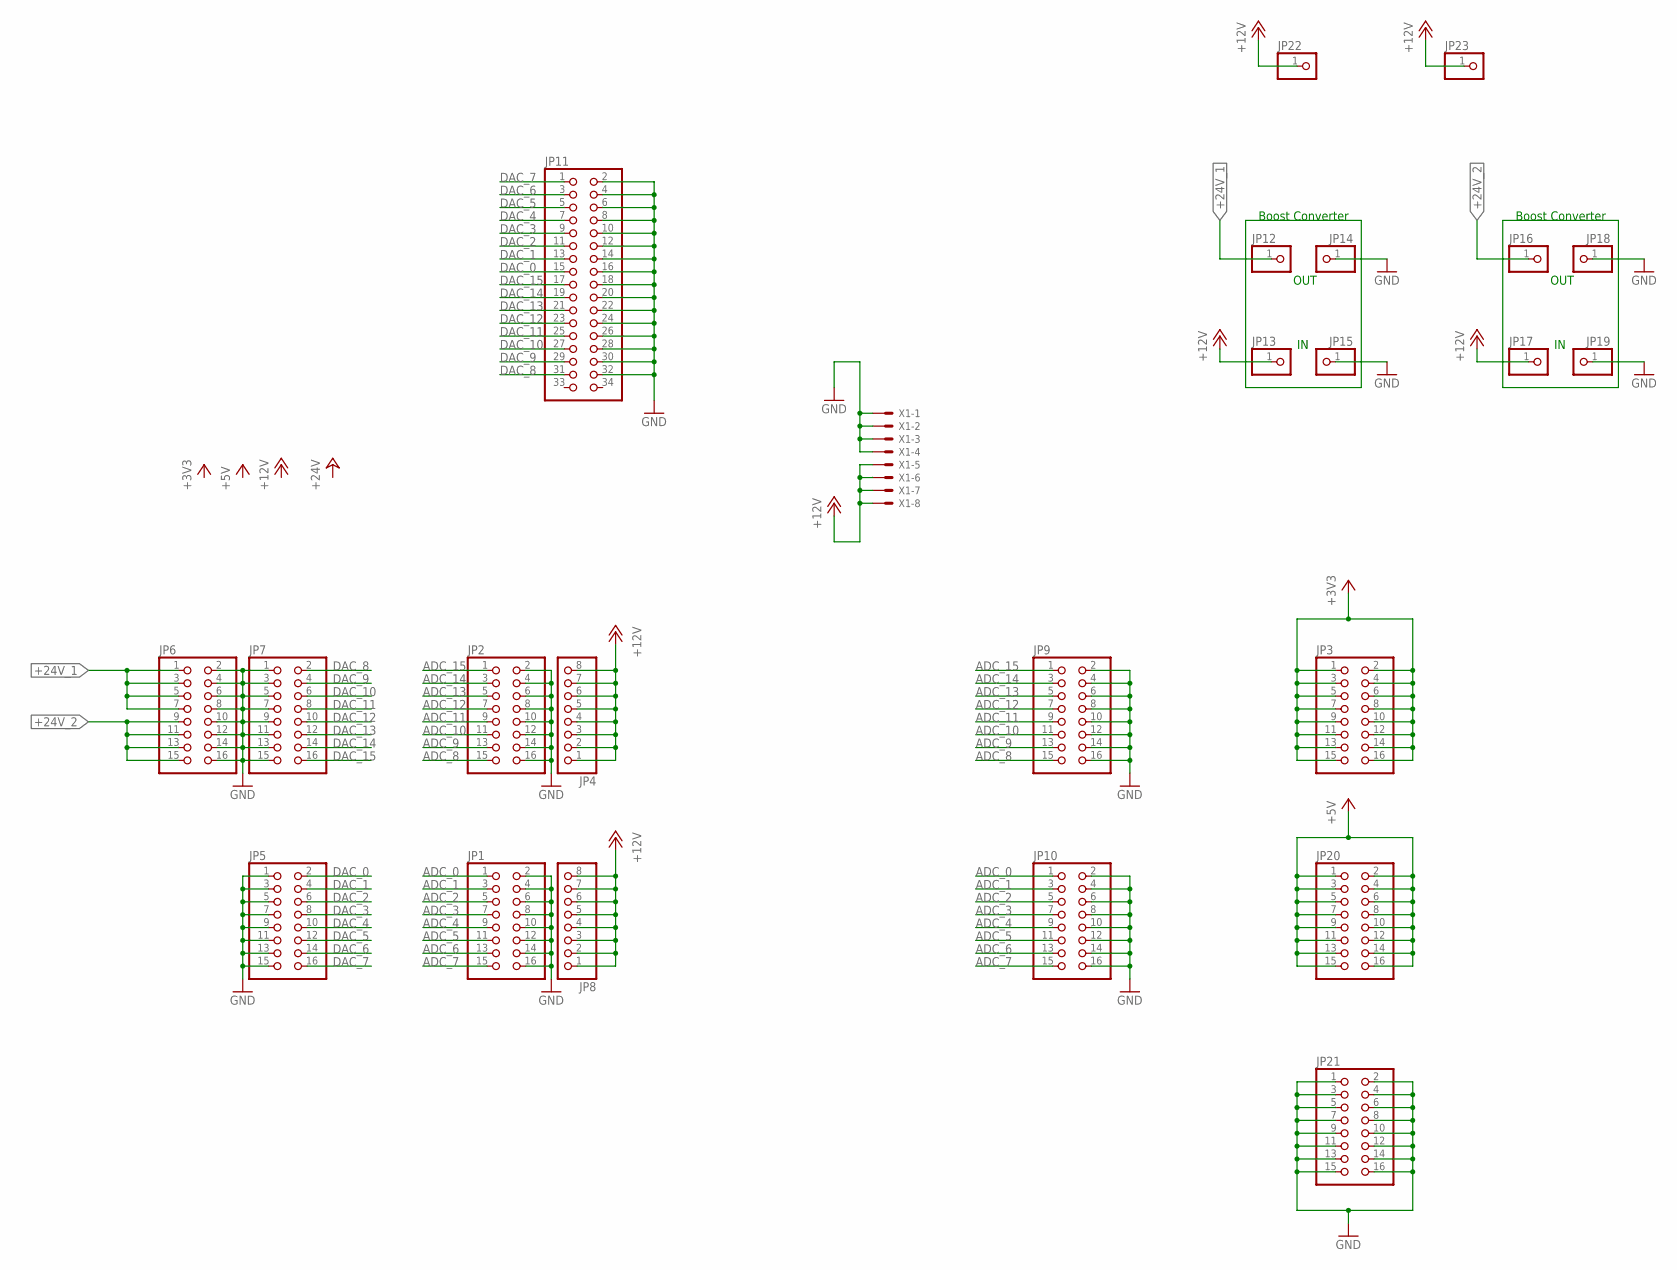
[picture p9: schematic tester_adapter_board.sch]

Parts:
JP1, JP2, JP3, JP5, JP6, JP7, JP9, JP10, JP20, JP21: PINHD-2X8; 2X08
JP4, JP8: PINHD-1X08_2.54-S; 1X08-S
JP11: PINHD-2X17; 2X17
JP12, JP13, JP16, JP17: PINHD-1X01_2.54; 1X01
JP14, JP15, JP18, JP19: PINHD-1X01_2.54-S; 1X01-S
JP22, JP23: PINHD-1X01_2.54-SMD; 1X01SMD
X1: 5566-8

Connections:
+3V3: JP3.1, JP3.2, JP3.3, JP3.4, JP3.5, JP3.6, JP3.7, JP3.8, JP3.9, JP3.10, JP3.11, JP3.12, JP3.13, JP3.14, JP3.15, JP3.16
+5V: JP20.1, JP20.2, JP20.3, JP20.4, JP20.5, JP20.6, JP20.7, JP20.8, JP20.9, JP20.10, JP20.11, JP20.12, JP20.13, JP20.14, JP20.15, JP20.16
+12V: JP4.1, JP4.2, JP4.3, JP4.4, JP4.5, JP4.6, JP4.7, JP4.8, JP8.1, JP8.2, JP8.3, JP8.4, JP8.5, JP8.6, JP8.7, JP8.8, JP13.1, JP17.1, JP22.1, JP23.1, X1.5, X1.6, X1.7, X1.8
+24V_1: JP6.1, JP6.3, JP6.5, JP6.7, JP12.1
+24V_2: JP6.9, JP6.11, JP6.13, JP6.15, JP16.1
ADC_0: JP1.1, JP10.1
ADC_1: JP1.3, JP10.3
ADC_2: JP1.5, JP10.5
ADC_3: JP1.7, JP10.7
ADC_4: JP1.9, JP10.9
ADC_5: JP1.11, JP10.11
ADC_6: JP1.13, JP10.13
ADC_7: JP1.15, JP10.15
ADC_8: JP2.15, JP9.15
ADC_9: JP2.13, JP9.13
ADC_10: JP2.11, JP9.11
ADC_11: JP2.9, JP9.9
ADC_12: JP2.7, JP9.7
ADC_13: JP2.5, JP9.5
ADC_14: JP2.3, JP9.3
ADC_15: JP2.1, JP9.1
DAC_0: JP5.2, JP11.15
DAC_1: JP5.4, JP11.13
DAC_2: JP5.6, JP11.11
DAC_3: JP5.8, JP11.9
DAC_4: JP5.10, JP11.7
DAC_5: JP5.12, JP11.5
DAC_6: JP5.14, JP11.3
DAC_7: JP5.16, JP11.1
DAC_8: JP7.2, JP11.31
DAC_9: JP7.4, JP11.29
DAC_10: JP7.6, JP11.27
DAC_11: JP7.8, JP11.25
DAC_12: JP7.10, JP11.23
DAC_13: JP7.12, JP11.21
DAC_14: JP7.14, JP11.19
DAC_15: JP7.16, JP11.17
GND: JP1.2, JP1.4, JP1.6, JP1.8, JP1.10, JP1.12, JP1.14, JP1.16, JP2.2, JP2.4, JP2.6, JP2.8, JP2.10, JP2.12, JP2.14, JP2.16, JP5.1, JP5.3, JP5.5, JP5.7, JP5.9, JP5.11, JP5.13, JP5.15, JP6.2, JP6.4, JP6.6, JP6.8, JP6.10, JP6.12, JP6.14, JP6.16, JP7.1, JP7.3, JP7.5, JP7.7, JP7.9, JP7.11, JP7.13, JP7.15, JP9.2, JP9.4, JP9.6, JP9.8, JP9.10, JP9.12, JP9.14, JP9.16, JP10.2, JP10.4, JP10.6, JP10.8, JP10.10, JP10.12, JP10.14, JP10.16, JP11.2, JP11.4, JP11.6, JP11.8, JP11.10, JP11.12, JP11.14, JP11.16, JP11.18, JP11.20, JP11.22, JP11.24, JP11.26, JP11.28, JP11.30, JP11.32, JP14.1, JP15.1, JP18.1, JP19.1, JP21.1, JP21.2, JP21.3, JP21.4, JP21.5, JP21.6, JP21.7, JP21.8, JP21.9, JP21.10, JP21.11, JP21.12, JP21.13, JP21.14, JP21.15, JP21.16, X1.1, X1.2, X1.3, X1.4

Notes on the sheet:
Boost Converter
OUT

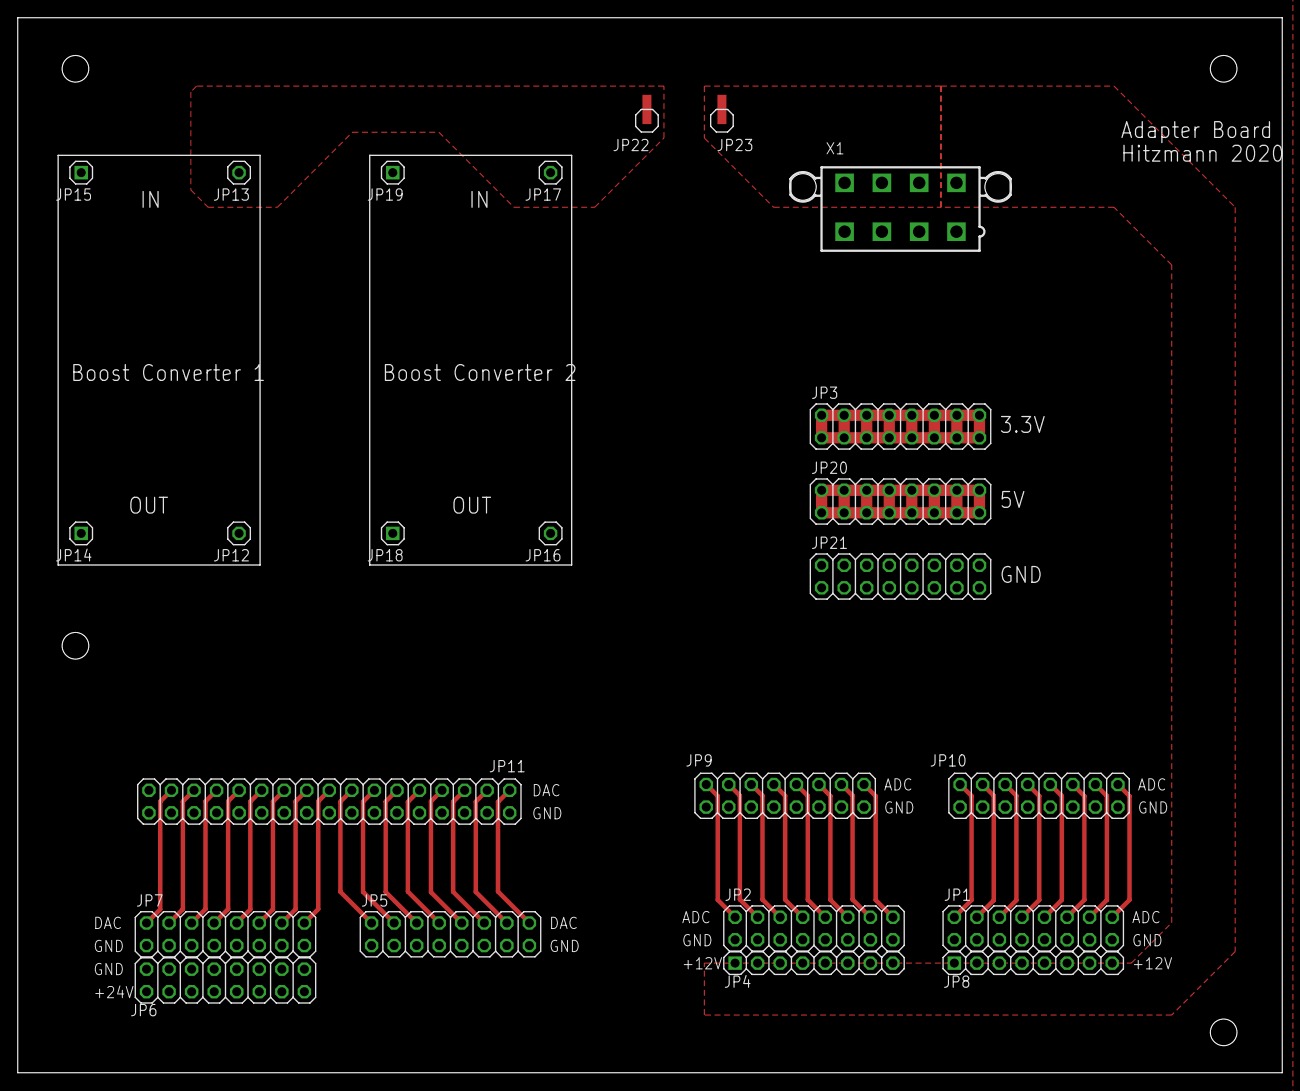
[picture p10: board tester_adapter_board.brd from above]

Board: 2 copper layers, 142.4 x 118.8 mm, 24 parts (0 on the bottom side), 38 nets.
