LiyiqiInOsakaUniversity/control_board_set/electronics/resistance_measuring_board.brd

## EAGLE design electronics/resistance_measuring_board.brd (2020-07-30)

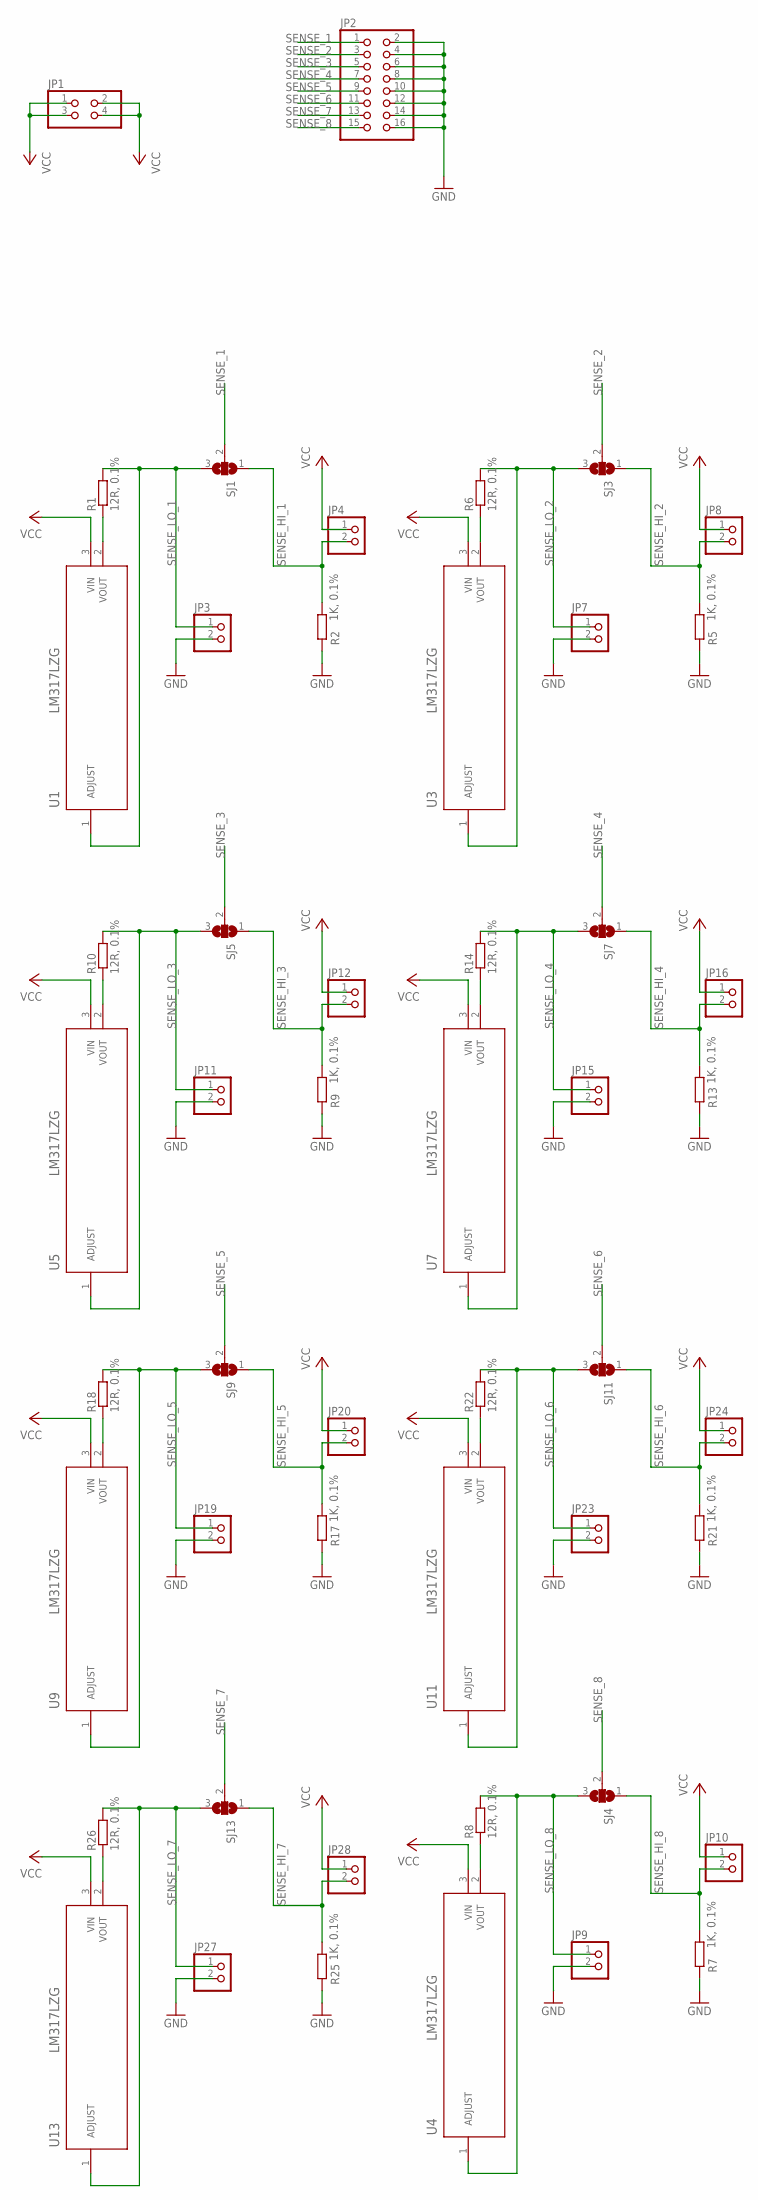
[picture p11: schematic resistance_measuring_board.sch]

Parts:
JP1: PINHD-2X2/90; 2X02/90
JP2: PINHD-2X8/90; 2X08/90
JP3, JP4, JP7, JP8, JP9, JP10, JP11, JP12, JP15, JP16, JP19, JP20, JP23, JP24, JP27, JP28: PINHD-1X2; 1X02
R1, R6, R8, R10, R14, R18, R22, R26: 12R, 0.1%; R0603
R2, R5, R7, R9, R13, R17, R21, R25: 1K, 0.1%; R1206
SJ1, SJ3, SJ4, SJ5, SJ7, SJ9, SJ11, SJ13: SJ2W; SJ_2
U1, U3, U4, U5, U7, U9, U11, U13: LM317LZG; TO-92_ONS

Connections:
GND: JP2.2, JP2.4, JP2.6, JP2.8, JP2.10, JP2.12, JP2.14, JP2.16, JP3.2, JP7.2, JP9.2, JP11.2, JP15.2, JP19.2, JP23.2, JP27.2, R2.1, R5.1, R7.1, R9.1, R13.1, R17.1, R21.1, R25.1
unnamed: R6.1, U3.2 (VOUT)
unnamed: R8.1, U4.2 (VOUT)
unnamed: R10.1, U5.2 (VOUT)
unnamed: R14.1, U7.2 (VOUT)
unnamed: R18.1, U9.2 (VOUT)
unnamed: R22.1, U11.2 (VOUT)
unnamed: R26.1, U13.2 (VOUT)
unnamed: R1.1, U1.2 (VOUT)
SENSE_1: JP2.1, SJ1.2
SENSE_2: JP2.3, SJ3.2
SENSE_3: JP2.5, SJ5.2
SENSE_4: JP2.7, SJ7.2
SENSE_5: JP2.9, SJ9.2
SENSE_6: JP2.11, SJ11.2
SENSE_7: JP2.13, SJ13.2
SENSE_8: JP2.15, SJ4.2
SENSE_HI_1: JP4.2, R2.2, SJ1.1
SENSE_HI_2: JP8.2, R5.2, SJ3.1
SENSE_HI_3: JP12.2, R9.2, SJ5.1
SENSE_HI_4: JP16.2, R13.2, SJ7.1
SENSE_HI_5: JP20.2, R17.2, SJ9.1
SENSE_HI_6: JP24.2, R21.2, SJ11.1
SENSE_HI_7: JP28.2, R25.2, SJ13.1
SENSE_HI_8: JP10.2, R7.2, SJ4.1
SENSE_LO_1: JP3.1, R1.2, SJ1.3, U1.1 (ADJUST)
SENSE_LO_2: JP7.1, R6.2, SJ3.3, U3.1 (ADJUST)
SENSE_LO_3: JP11.1, R10.2, SJ5.3, U5.1 (ADJUST)
SENSE_LO_4: JP15.1, R14.2, SJ7.3, U7.1 (ADJUST)
SENSE_LO_5: JP19.1, R18.2, SJ9.3, U9.1 (ADJUST)
SENSE_LO_6: JP23.1, R22.2, SJ11.3, U11.1 (ADJUST)
SENSE_LO_7: JP27.1, R26.2, SJ13.3, U13.1 (ADJUST)
SENSE_LO_8: JP9.1, R8.2, SJ4.3, U4.1 (ADJUST)
VCC: JP1.1, JP1.2, JP1.3, JP1.4, JP4.1, JP8.1, JP10.1, JP12.1, JP16.1, JP20.1, JP24.1, JP28.1, U1.3 (VIN), U3.3 (VIN), U4.3 (VIN), U5.3 (VIN), U7.3 (VIN), U9.3 (VIN), U11.3 (VIN), U13.3 (VIN)

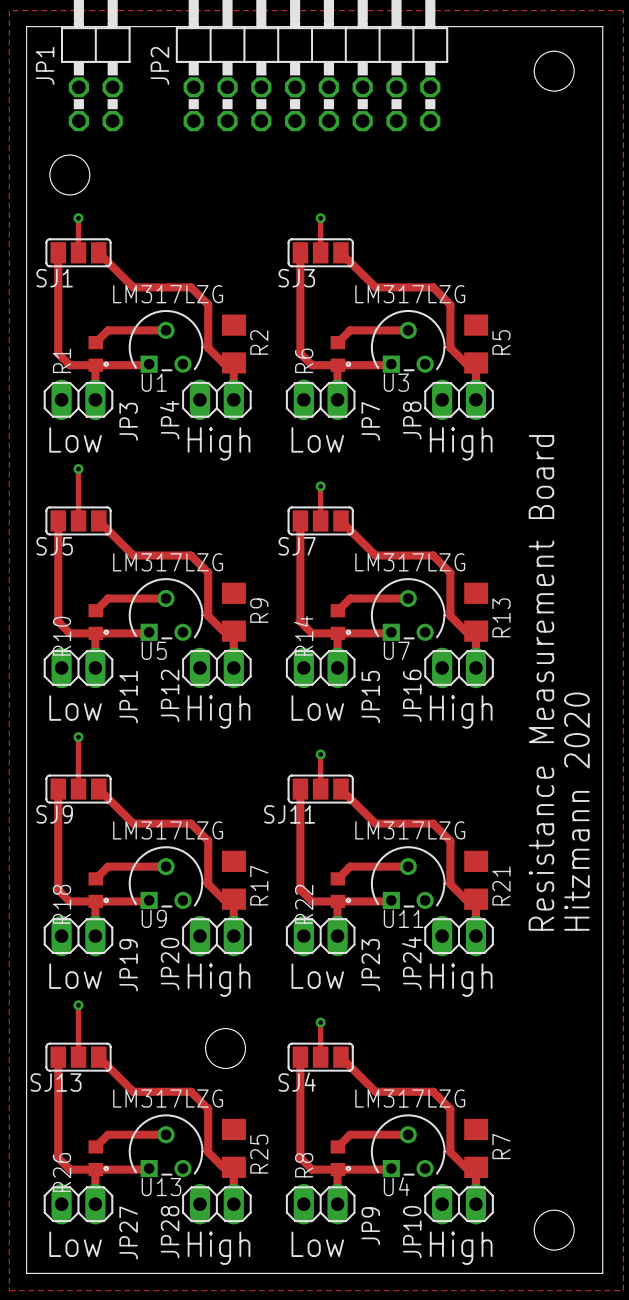
[picture p12: board resistance_measuring_board.brd from above]

Board: 4 copper layers, 43.3 x 93.7 mm, 50 parts (0 on the bottom side), 34 nets.
