LiyiqiInOsakaUniversity/control_board_set/electronics/wheatstone_bridge_board.brd

## EAGLE design electronics/wheatstone_bridge_board.brd (2020-07-30)

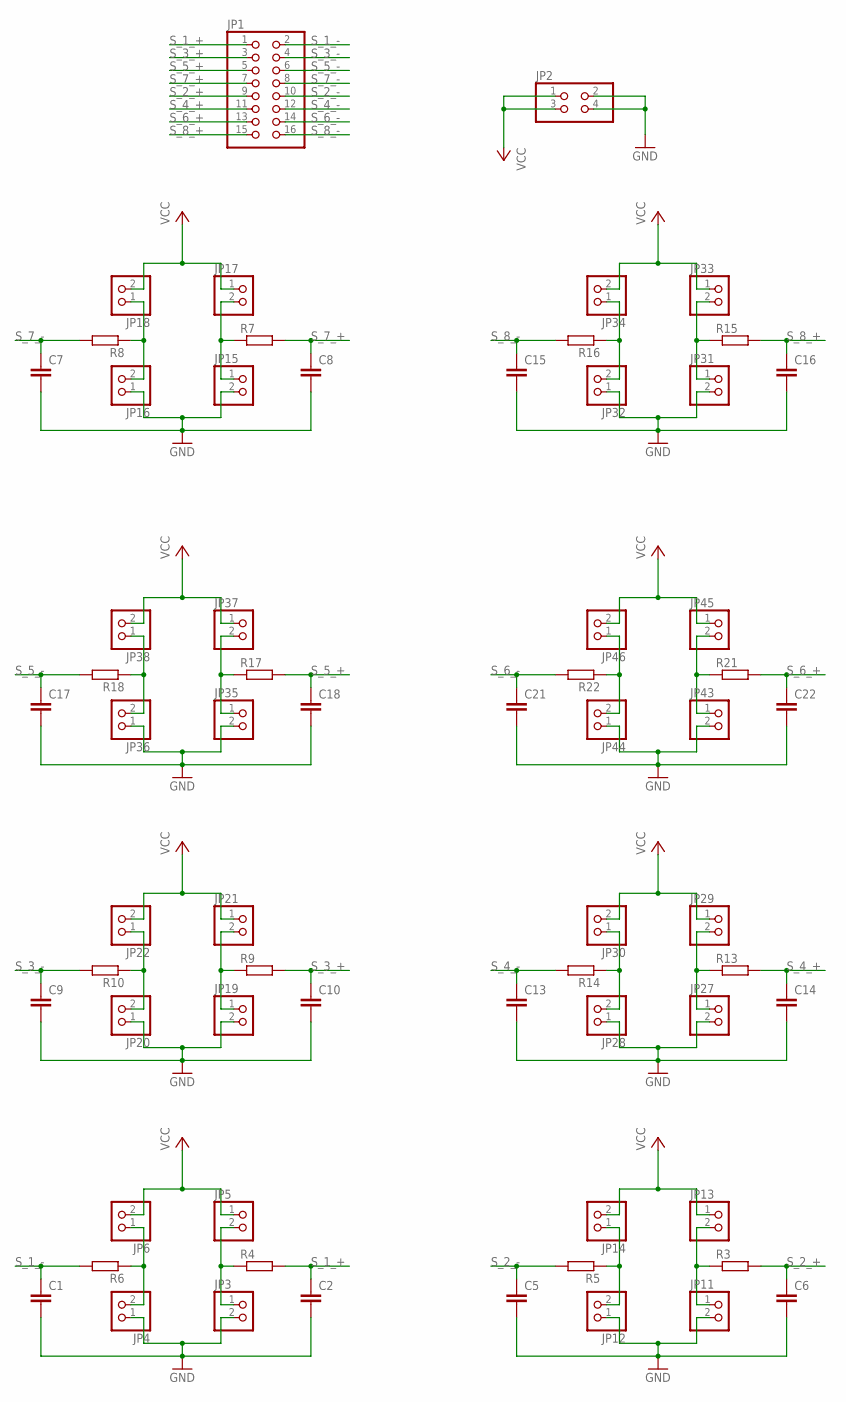
[picture p13: schematic wheatstone_bridge_board.sch]

Parts:
C1, C2, C5, C6, C7, C8, C9, C10, C13, C14, C15, C16, C17, C18, C21, C22: C-EU025-050X050; C025-050X050
JP1: PINHD-2X8/90; 2X08/90
JP2: PINHD-2X2/90; 2X02/90
JP3, JP4, JP5, JP6, JP11, JP12, JP13, JP14, JP15, JP16, JP17, JP18, JP19, JP20, JP21, JP22, JP27, JP28, JP29, JP30, JP31, JP32, JP33, JP34, JP35, JP36, JP37, JP38, JP43, JP44, JP45, JP46: PINHD-1X2; 1X02
R3, R4, R5, R6, R7, R8, R9, R10, R13, R14, R15, R16, R17, R18, R21, R22: R-EU_R0603; R0603

Connections:
GND: C1.2, C2.2, C5.2, C6.2, C7.2, C8.2, C9.2, C10.2, C13.2, C14.2, C15.2, C16.2, C17.2, C18.2, C21.2, C22.2, JP2.2, JP2.4, JP3.2, JP4.1, JP11.2, JP12.1, JP15.2, JP16.1, JP19.2, JP20.1, JP27.2, JP28.1, JP31.2, JP32.1, JP35.2, JP36.1, JP43.2, JP44.1
unnamed: JP4.2, JP6.1, R6.1
unnamed: JP3.1, JP5.2, R4.1
unnamed: JP12.2, JP14.1, R5.1
unnamed: JP11.1, JP13.2, R3.1
unnamed: JP16.2, JP18.1, R8.1
unnamed: JP15.1, JP17.2, R7.1
unnamed: JP20.2, JP22.1, R10.1
unnamed: JP19.1, JP21.2, R9.1
unnamed: JP28.2, JP30.1, R14.1
unnamed: JP27.1, JP29.2, R13.1
unnamed: JP32.2, JP34.1, R16.1
unnamed: JP31.1, JP33.2, R15.1
unnamed: JP36.2, JP38.1, R18.1
unnamed: JP35.1, JP37.2, R17.1
unnamed: JP44.2, JP46.1, R22.1
unnamed: JP43.1, JP45.2, R21.1
S_1_+: C2.1, JP1.1, R4.2
S_1_-: C1.1, JP1.2, R6.2
S_2_+: C6.1, JP1.9, R3.2
S_2_-: C5.1, JP1.10, R5.2
S_3_+: C10.1, JP1.3, R9.2
S_3_-: C9.1, JP1.4, R10.2
S_4_+: C14.1, JP1.11, R13.2
S_4_-: C13.1, JP1.12, R14.2
S_5_+: C18.1, JP1.5, R17.2
S_5_-: C17.1, JP1.6, R18.2
S_6_+: C22.1, JP1.13, R21.2
S_6_-: C21.1, JP1.14, R22.2
S_7_+: C8.1, JP1.7, R7.2
S_7_-: C7.1, JP1.8, R8.2
S_8_+: C16.1, JP1.15, R15.2
S_8_-: C15.1, JP1.16, R16.2
VCC: JP2.1, JP2.3, JP5.1, JP6.2, JP13.1, JP14.2, JP17.1, JP18.2, JP21.1, JP22.2, JP29.1, JP30.2, JP33.1, JP34.2, JP37.1, JP38.2, JP45.1, JP46.2

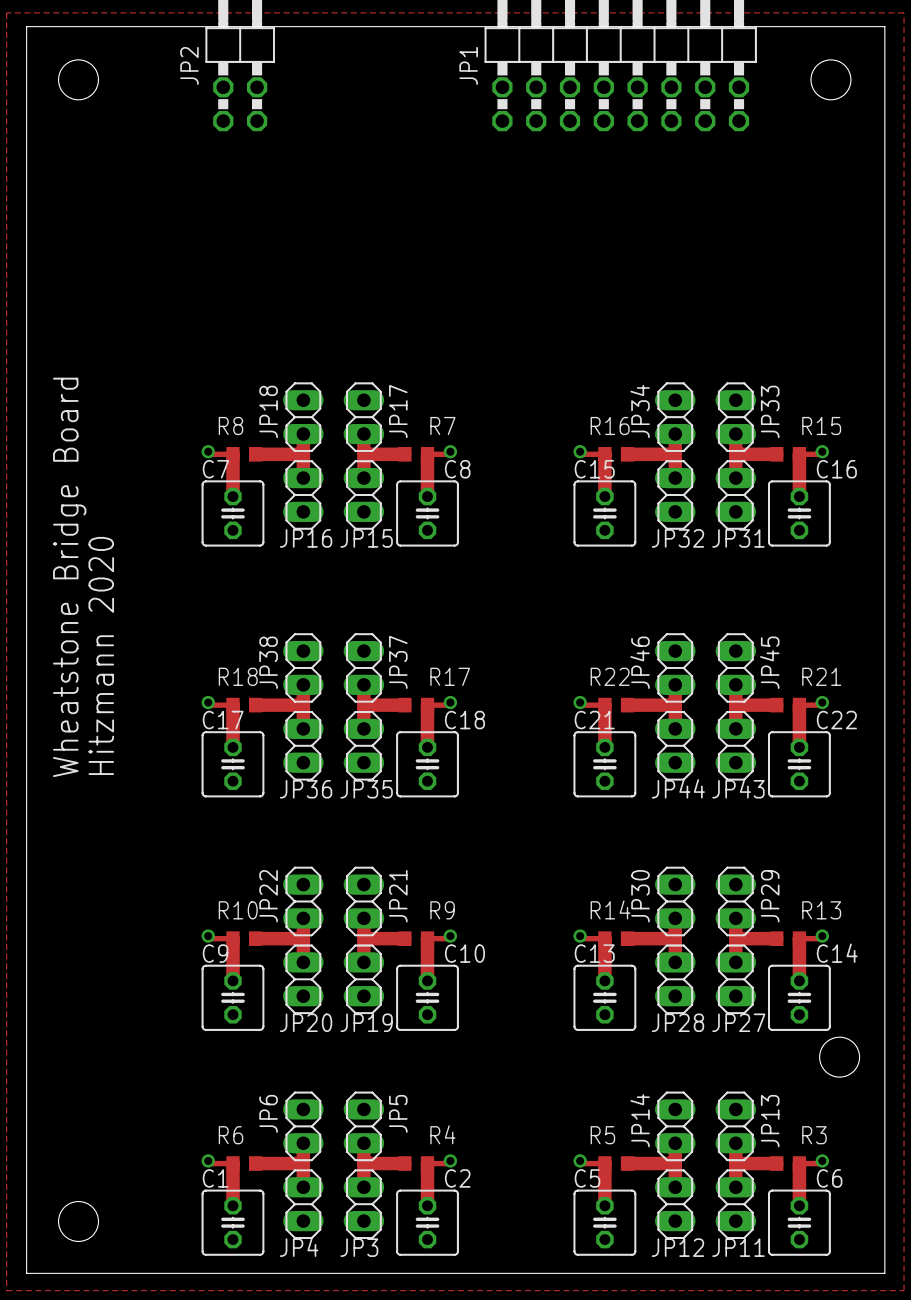
[picture p14: board wheatstone_bridge_board.brd from above]

Board: 4 copper layers, 64.5 x 93.7 mm, 66 parts (0 on the bottom side), 34 nets.
