LiyiqiInOsakaUniversity/control_board_set/firmware/teensy/teensy_spi.cpp

#include "teensy_spi.h"

Teensy_SPI::Teensy_SPI(Teensy_GPIO *gpio) : Embedded_SPI(gpio)  {
  _gpio = gpio;
  SPI.begin();
  //bcm2835_spi_setBitOrder(BCM2835_SPI_BIT_ORDER_MSBFIRST);
  //bcm2835_spi_setDataMode(BCM2835_SPI_MODE1);
  //bcm2835_spi_setClockDivider(BCM2835_SPI_CLOCK_DIVIDER_32);
  //bcm2835_spi_chipSelect(BCM2835_SPI_CS_NONE);
  //bcm2835_spi_setChipSelectPolarity(BCM2835_SPI_CS_NONE, LOW);

};

Teensy_SPI::~Teensy_SPI() {
};

bool Teensy_SPI::transferSPI(int cs, int data_len, char data[]) {
  SPISettings spi_settings(20000000, MSBFIRST, SPI_MODE1);
  _gpio->set_output(cs, Embedded_GPIO::gpio_state::EMB_OFF);
  SPI.beginTransaction(spi_settings);
  SPI.transfer(data, data_len);
  SPI.endTransaction();
  _gpio->set_output(cs, Embedded_GPIO::gpio_state::EMB_ON);
  return true;
}

bool Teensy_SPI::transferSPI(int cs, int data_len, char data_tx[], char data_rx[]) {
  SPISettings spi_settings(2000000, MSBFIRST, SPI_MODE1);
  _gpio->set_output(cs, Embedded_GPIO::gpio_state::EMB_OFF);
  SPI.beginTransaction(spi_settings);
  for(int idx = 0; idx < data_len; idx++)
  {
    data_rx[idx] = SPI.transfer(data_tx[idx]);
  }
  SPI.endTransaction();
  _gpio->set_output(cs, Embedded_GPIO::gpio_state::EMB_ON);
  return true;
}

void Teensy_SPI::micro_wait()
{
  asm volatile("nop");
  asm volatile("nop");
  asm volatile("nop");
  asm volatile("nop");
  asm volatile("nop");
  asm volatile("nop");
  asm volatile("nop");
  asm volatile("nop");
  asm volatile("nop");
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
  asm volatile("nop");
  asm volatile("nop");
  asm volatile("nop");
  asm volatile("nop");
  asm volatile("nop");
  asm volatile("nop");
  asm volatile("nop");
  asm volatile("nop");
  asm volatile("nop");
  asm volatile("nop");
  asm volatile("nop");
  asm volatile("nop");
}
