LiyiqiInOsakaUniversity/control_board_set/firmware/teensy/ad5360.cpp

#include "ad5360.h"

AD5360::AD5360(Embedded_SPI *dev) {
  _dev = dev;
}

void AD5360::setVoltage(int cs, uint8_t group, uint8_t channel, double voltage) {
  buildDataCommandHeader(group, channel);
  buildDataCommandValue(voltage);
  writeCommand(cs);
}

void AD5360::setNormalized(int cs, uint8_t group, uint8_t channel, double value) {
  buildDataCommandHeader(group, channel);
  buildDataCommandValue(map(value, -1, 1, 0, (AD5360_REF_VOLTAGE * 2)));
  writeCommand(cs);
}

void AD5360::setGain(int cs, uint8_t group, uint8_t channel, uint16_t gain) {
  buildGainCommandHeader(group, channel);
  buildCalibrationCommandValue(gain);
  writeCommand(cs);
}

void AD5360::setOffset(int cs, uint8_t group, uint8_t channel, uint16_t offset) {
  buildOffsetCommandHeader(group, channel);
  buildCalibrationCommandValue(offset);
  writeCommand(cs);
}

void AD5360::reset(int cs, uint8_t group, uint8_t channel) {
  setOffset(cs, group, channel, AD5360_DEFAULT_OFFSET);
  setGain(cs, group, channel, AD5360_DEFAULT_GAIN);
  setVoltage(cs, group, channel, 0.0);
}

void AD5360::writeCommand(int cs) {
  char data[3];
  data[0] = _spi_tx_buffer[0];
  data[1] = _spi_tx_buffer[1];
  data[2] = _spi_tx_buffer[2];
  _dev->transferSPI(cs, 3, data);
}

void AD5360::buildDataCommandHeader(uint8_t group, uint8_t channel) {
  _spi_tx_buffer[0] = AD5360_MODE_WRITE_DAC_DATA;
  _spi_tx_buffer[0] = _spi_tx_buffer[0] | (group + (uint8_t) 1) << 3;
  _spi_tx_buffer[0] = _spi_tx_buffer[0] | channel;
}

void AD5360::buildGainCommandHeader(uint8_t group, uint8_t channel) {
  _spi_tx_buffer[0] = AD5360_MODE_WRITE_DAC_GAIN;
  _spi_tx_buffer[0] = _spi_tx_buffer[0] | (group + (uint8_t) 1) << 3;
  _spi_tx_buffer[0] = _spi_tx_buffer[0] | channel;
}

void AD5360::buildOffsetCommandHeader(uint8_t group, uint8_t channel) {
  _spi_tx_buffer[0] = AD5360_MODE_WRITE_DAC_OFFSET;
  _spi_tx_buffer[0] = _spi_tx_buffer[0] | (group + (uint8_t) 1) << 3;
  _spi_tx_buffer[0] = _spi_tx_buffer[0] | channel;
}

void AD5360::buildDataCommandValue(double voltage) {
  if (voltage == 0.0) {
    uint16_t command_data = pow(2, 16) / 2;
    _spi_tx_buffer[1] = (uint8_t) ((command_data & 0xFF00) >> 8);
    _spi_tx_buffer[2] = (uint8_t) (command_data & 0x00FF);
  } else if (voltage <= (2 * AD5360_REF_VOLTAGE) * -1) {
    _spi_tx_buffer[1] = 0;
    _spi_tx_buffer[2] = 0;
  } else if (voltage >= (2 * AD5360_REF_VOLTAGE)) {
    uint16_t command_data = pow(2, 16) - 1;
    _spi_tx_buffer[1] = (uint8_t) ((command_data & 0xFF00) >> 8);
    _spi_tx_buffer[2] = (uint8_t) (command_data & 0x00FF);
  } else {

    uint16_t command_data = pow(2, 16) / 2;
    uint16_t value = fabs(voltage) / ((AD5360_REF_VOLTAGE * 2) / pow(2, 15));

    if (voltage > 0) {
      command_data += value;
    } else {
      command_data -= value;
    }

    _spi_tx_buffer[1] = (uint8_t) ((command_data & 0xFF00) >> 8);
    _spi_tx_buffer[2] = (uint8_t) (command_data & 0x00FF);
  }
}

void AD5360::buildCalibrationCommandValue(uint16_t value) {
  _spi_tx_buffer[1] = (uint8_t) ((value & 0xFF00) >> 8);
  _spi_tx_buffer[2] = (uint8_t) (value & 0x00FF);
}

double AD5360::map(double x, double in_min, double in_max, double out_min, double out_max){
  return (x - in_min) * (out_max - out_min) / (in_max - in_min) + out_min;
}
