LiyiqiInOsakaUniversity/control_board_set/(commit log)

2020-07-30 rev 0.1
    [control_board.brd, resistance_measuring_board.brd, resistance_measuring_board.sch, wheatstone_bridge_board.brd]
2020-07-30 added GND to Teensy
    [control_board.brd, control_board.sch]
2020-07-31 added caps and logo to control board
    [control_board.brd, control_board.sch]
2020-09-16 added firmware code snippets
    [control_board.brd, control_board.sch, resistance_measuring_board.brd, resistance_measuring_board.sch, wheatstone_bridge_board.brd, wheatstone_bridge_board.sch]
2020-09-18 teensy test v0.0
    [control_board.brd, control_board.sch]
2020-11-19 added raspi firmware
    [control_board.brd, control_board.sch, tester_adapter_board.brd, tester_adapter_board.sch]
2020-12-09 fixed adc data order
2020-12-16 added deprecation notice for teensy
2020-12-22 added correct indices for adc and dac of muscles in muscle_test
    [muscle_test.cpp]
2021-05-03 fixed order of adc results
